cjsatuforc/Mendel-90/Build Manual (DRAFT - NOT COMPLETE OR VERIFIED)/link to extruder assembly instructions.txt

http://reprap.org/wiki/Prusa_i3_Rework_Extruder_assembly
