cjsatuforc/Mendel-90/Electronics/ATX PSU.step

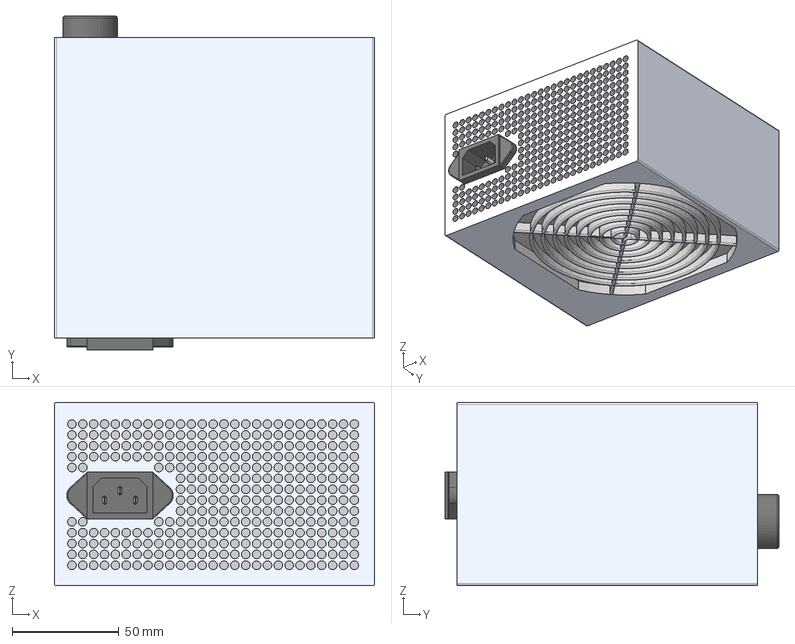
[picture p1: CAD file, 2018-10-25]
Electronics/ATX PSU.step
149.9 x 156.2 x 85.7 mm
