cjsatuforc/Mendel-90/Hardware/8mm Smooth Rod 481mm.step

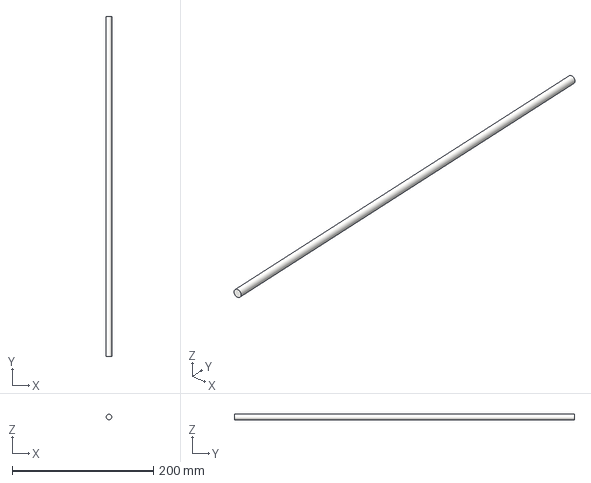
[picture p2: CAD file, 2018-10-25]
Hardware/8mm Smooth Rod 481mm.step
7.99 x 481.0 x 8.00 mm
