cjsatuforc/Mendel-90/Printed Parts/Enclosure/Hinge 1.step

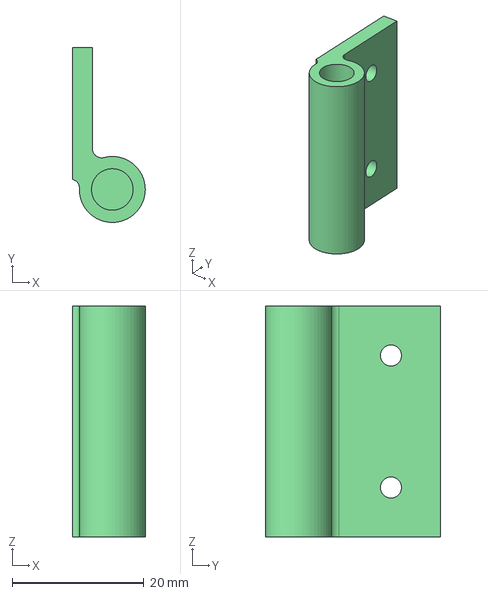
[picture p3: CAD file, 2018-10-25]
Printed Parts/Enclosure/Hinge 1.step
11.0 x 26.5 x 35.0 mm
