cjsatuforc/Mendel-90/Printed Parts/fan guard.step

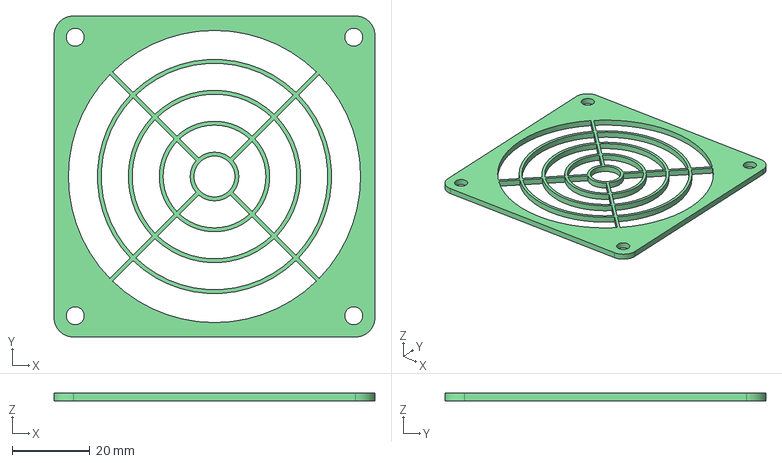
[picture p4: CAD file, 2018-10-25]
Printed Parts/fan guard.step
82.4 x 82.4 x 2.00 mm
