cjsatuforc/Mendel-90/Sheets/Base.step

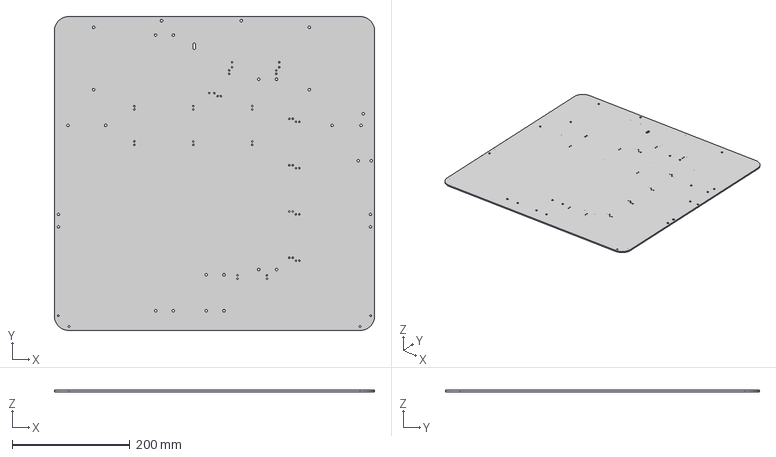
[picture p5: CAD file, 2018-10-25]
Sheets/Base.step
544.0 x 533.0 x 3.00 mm
