cjsatuforc/Mendel-90/Sheets/Enclosure/Rear 2.step

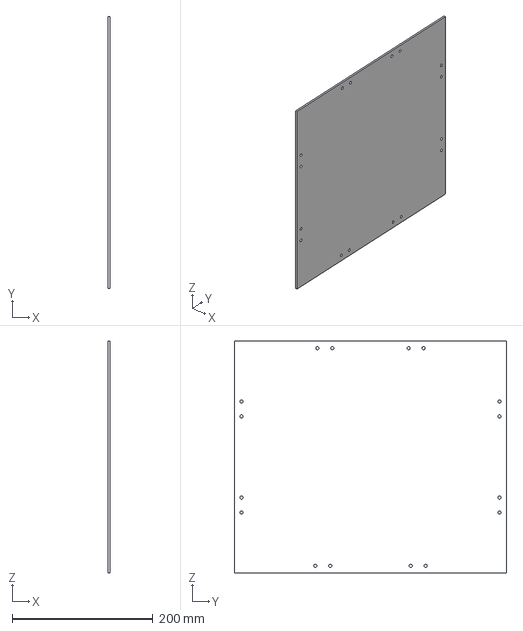
[picture p6: CAD file, 2018-10-25]
Sheets/Enclosure/Rear 2.step
3.00 x 386.7 x 329.4 mm
