cjsatuforc/Mendel-90/Printed Parts/Enclosure/Front Left.step

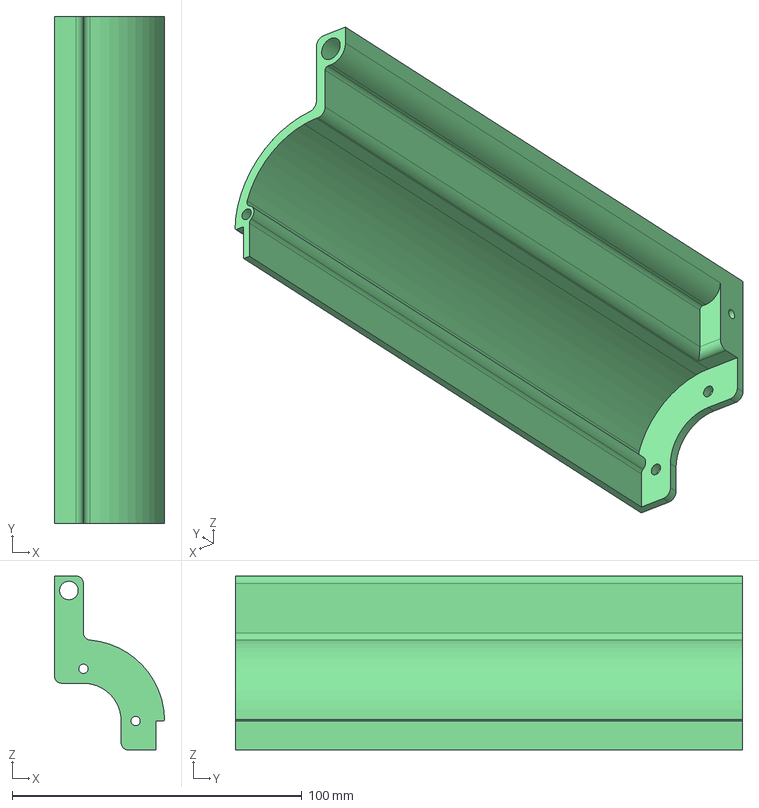
[picture p7: CAD file, 2018-10-25]
Printed Parts/Enclosure/Front Left.step
38.0 x 175.0 x 60.0 mm
