cjsatuforc/Mendel-90/Printed Parts/y motor bracket.step

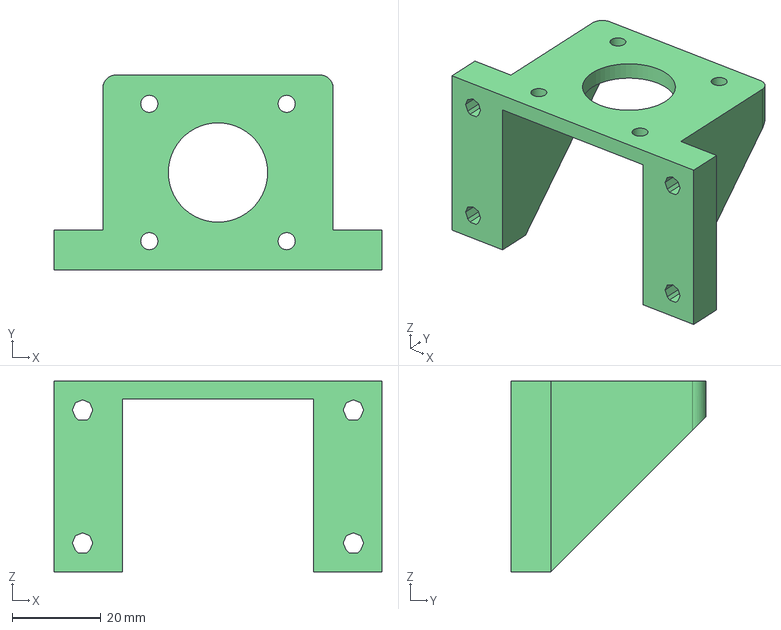
[picture p8: CAD file, 2018-10-25]
Printed Parts/y motor bracket.step
74.0 x 44.0 x 43.0 mm
