cjsatuforc/Mendel-90/Sheets/Enclosure/Back Window.step

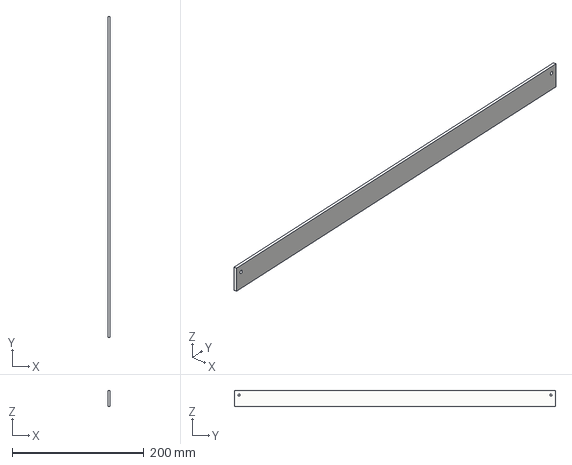
[picture p9: CAD file, 2018-10-25]
Sheets/Enclosure/Back Window.step
3.00 x 488.0 x 25.0 mm
