cjsatuforc/Mendel-90/Sheets/Gantry.step

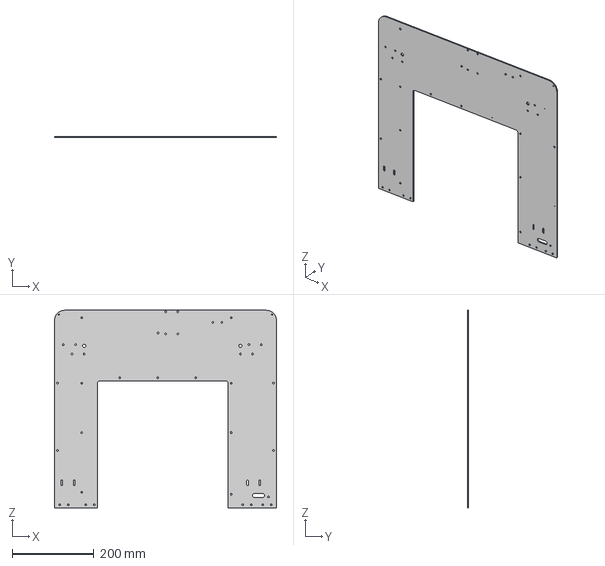
[picture p10: CAD file, 2018-10-25]
Sheets/Gantry.step
544.0 x 3.00 x 484.0 mm
