cjsatuforc/Mendel-90/Printed Parts/Enclosure/Front Left Bottom Bracket.step

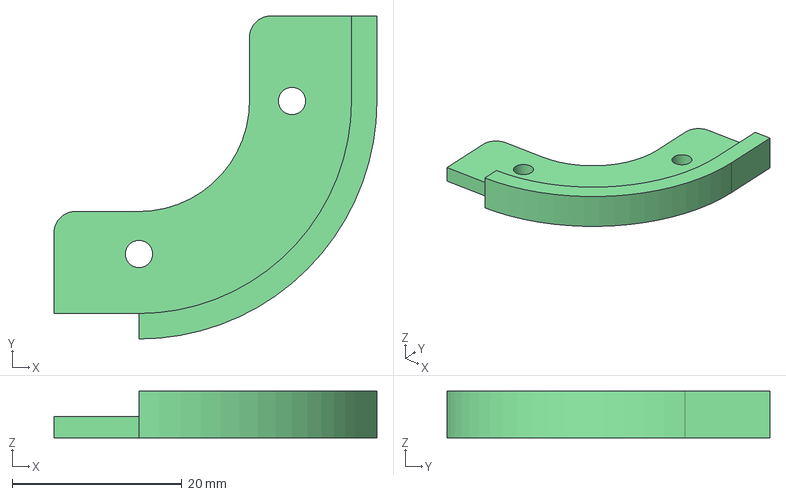
[picture p11: CAD file, 2018-10-25]
Printed Parts/Enclosure/Front Left Bottom Bracket.step
38.0 x 38.0 x 5.50 mm
