cjsatuforc/Mendel-90/Printed Parts/filament holder.step

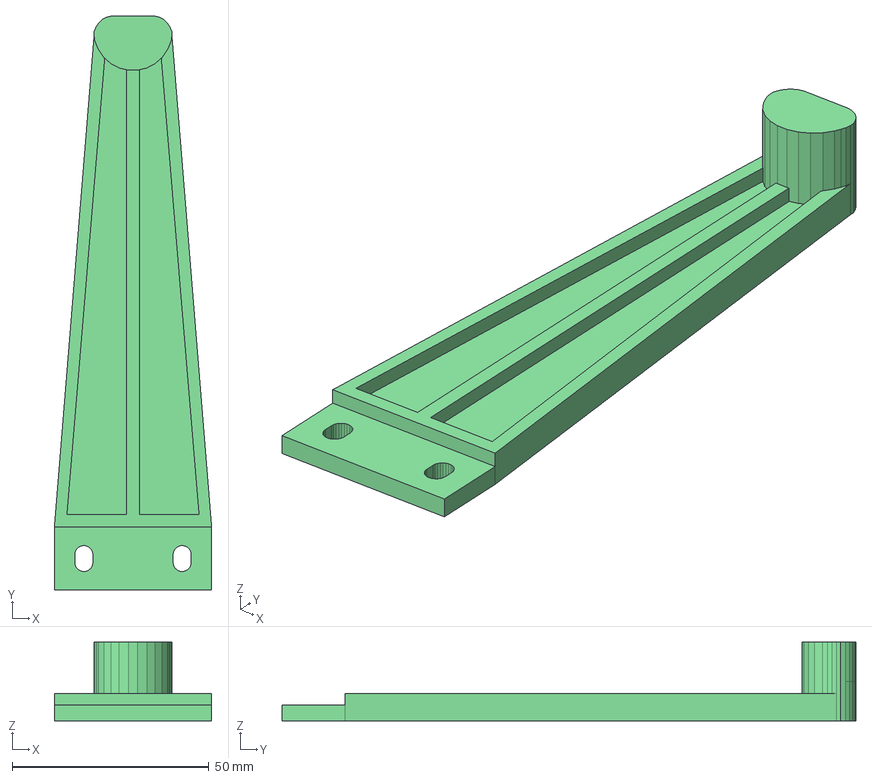
[picture p12: CAD file, 2018-10-25]
Printed Parts/filament holder.step
40.0 x 146.0 x 20.0 mm
