cjsatuforc/Mendel-90/Sheets/Enclosure/Door.step

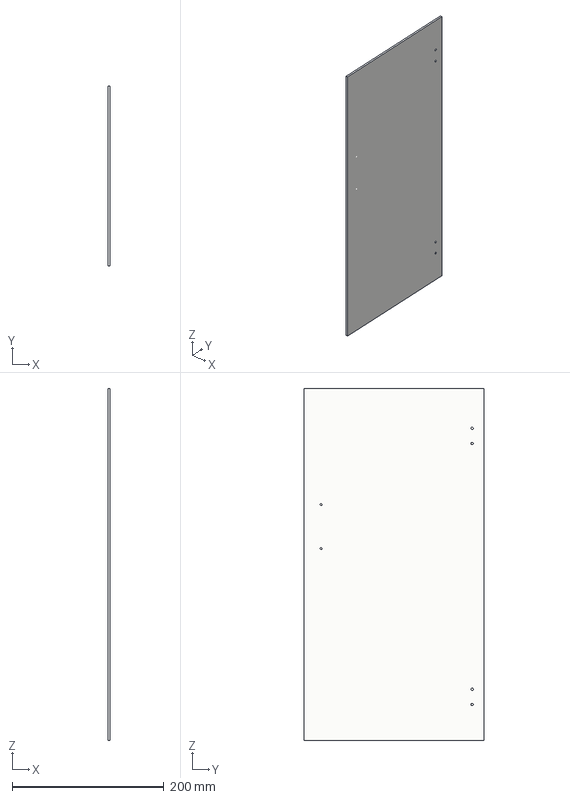
[picture p13: CAD file, 2018-10-25]
Sheets/Enclosure/Door.step
3.00 x 237.0 x 464.0 mm
