cjsatuforc/Mendel-90/Sheets/Y carriage.step

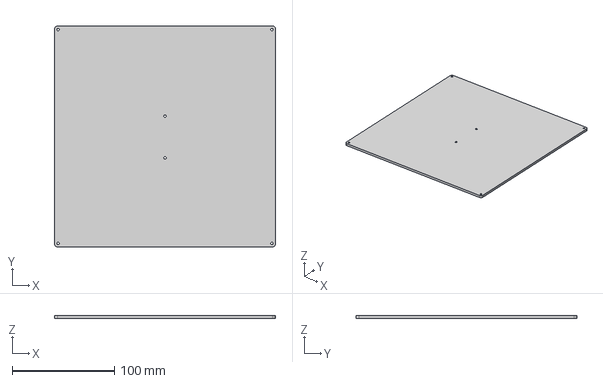
[picture p14: CAD file, 2018-10-25]
Sheets/Y carriage.step
216.0 x 216.0 x 3.00 mm
