cjsatuforc/Mendel-90/Hardware/8mm Smooth Rod 336mm.step

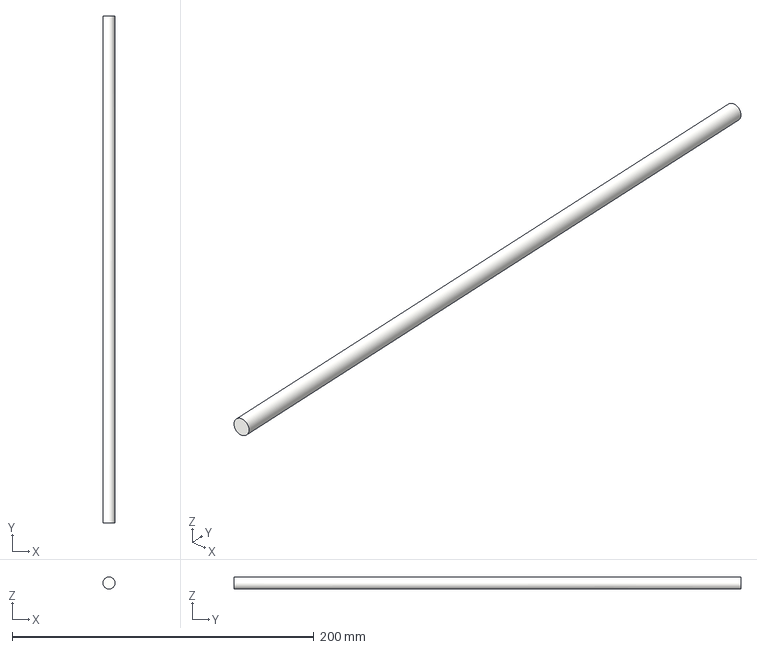
[picture p15: CAD file, 2018-10-25]
Hardware/8mm Smooth Rod 336mm.step
8.00 x 336.0 x 8.00 mm
