cjsatuforc/Mendel-90/Printed Parts/Enclosure/Top Right Guide 2.step

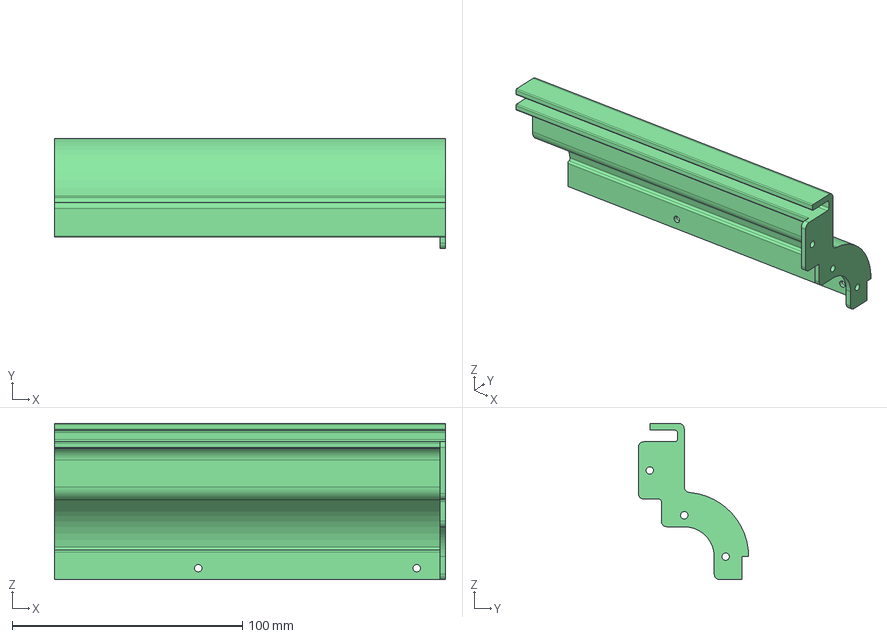
[picture p16: CAD file, 2018-10-25]
Printed Parts/Enclosure/Top Right Guide 2.step
170.0 x 48.0 x 68.0 mm
