cjsatuforc/Mendel-90/Printed Parts/Z bar clamp.step

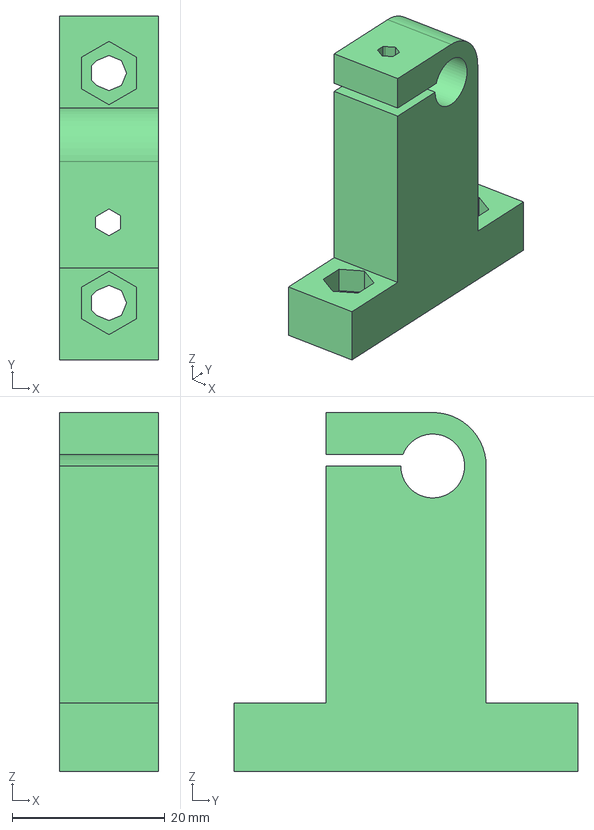
[picture p17: CAD file, 2018-10-25]
Printed Parts/Z bar clamp.step
13.0 x 45.0 x 47.0 mm
