cjsatuforc/Mendel-90/Sheets/Enclosure/Side Window.step

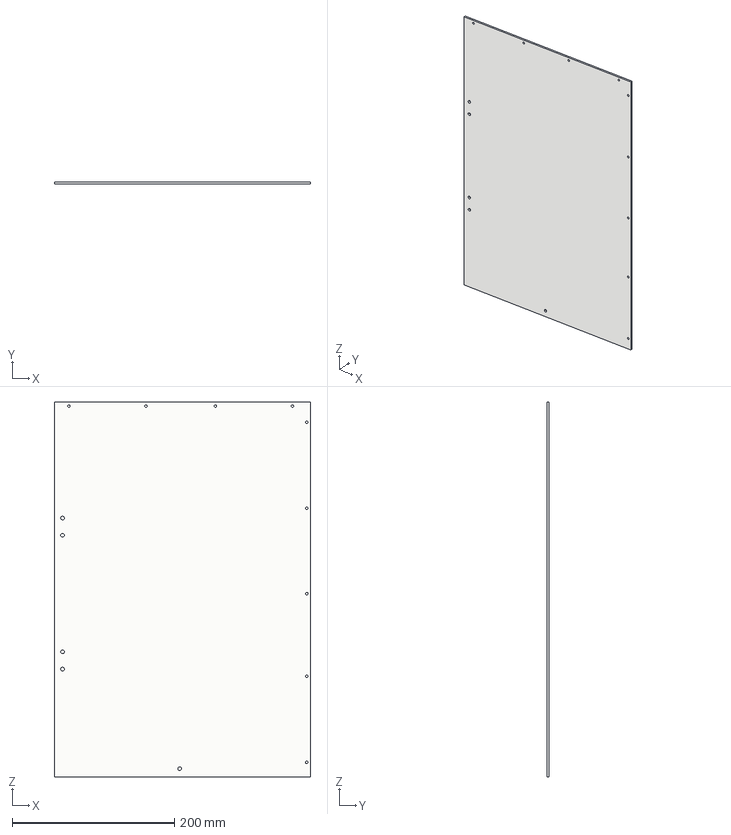
[picture p18: CAD file, 2018-10-25]
Sheets/Enclosure/Side Window.step
316.0 x 3.00 x 462.0 mm
