cjsatuforc/Mendel-90/Sheets/Left.step

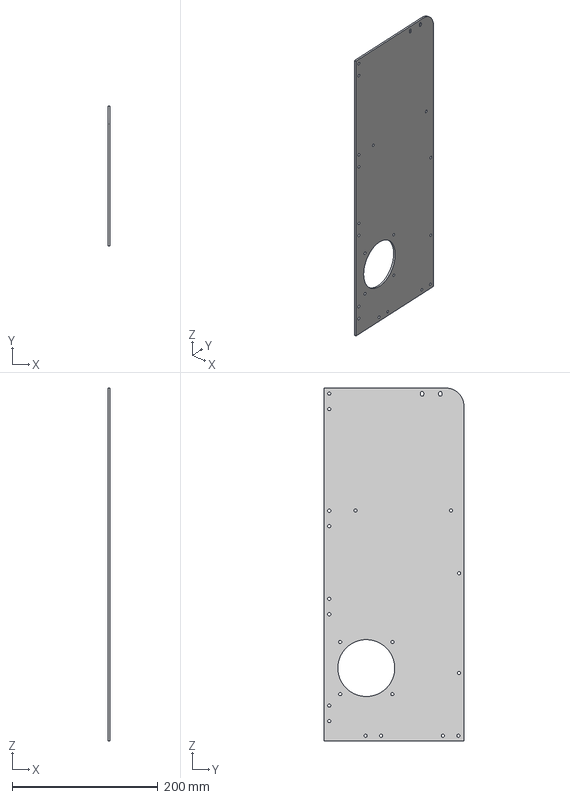
[picture p19: CAD file, 2018-10-25]
Sheets/Left.step
3.00 x 192.0 x 484.0 mm
