cjsatuforc/Mendel-90/Hardware/Flexible Coupling.step

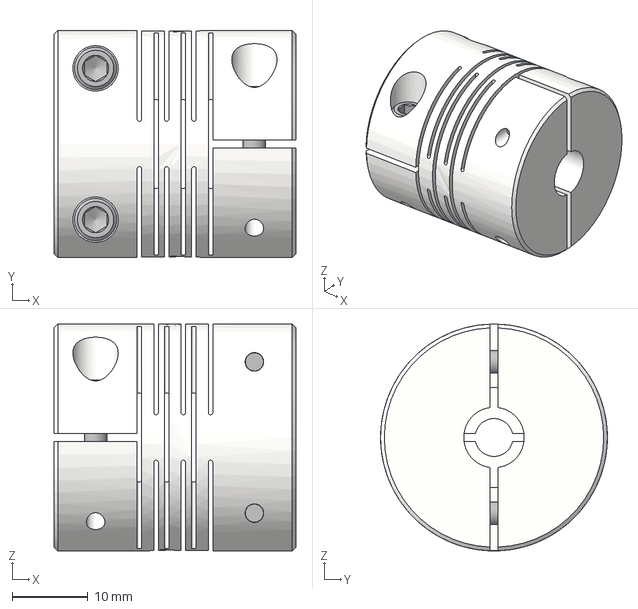
[picture p20: CAD file, 2018-10-25]
Hardware/Flexible Coupling.step
32.0 x 30.0 x 30.0 mm
_Type1-8.5x12
_Type11 x 4
