cjsatuforc/Mendel-90/Printed Parts/Enclosure/Top Left Guide 1.step

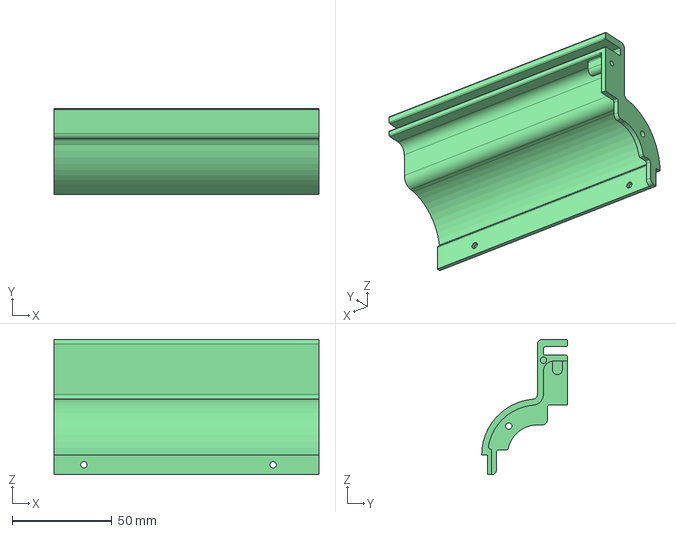
[picture p21: CAD file, 2018-10-25]
Printed Parts/Enclosure/Top Left Guide 1.step
133.0 x 43.0 x 68.0 mm
