cjsatuforc/Mendel-90/Printed Parts/Z Stepper Bracket RHS.step

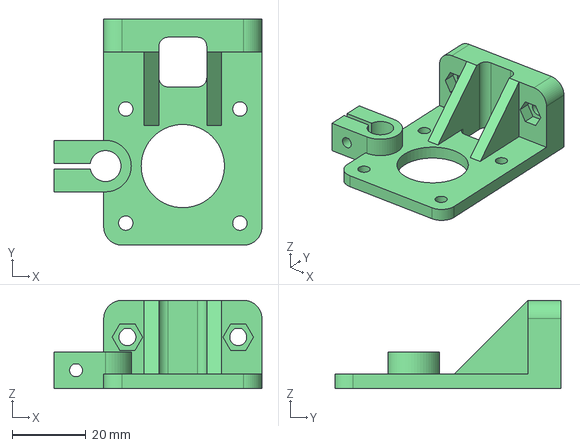
[picture p22: CAD file, 2018-10-25]
Printed Parts/Z Stepper Bracket RHS.step
56.5 x 61.5 x 24.0 mm
