cjsatuforc/Mendel-90/Sheets/Enclosure/Rear 1.step

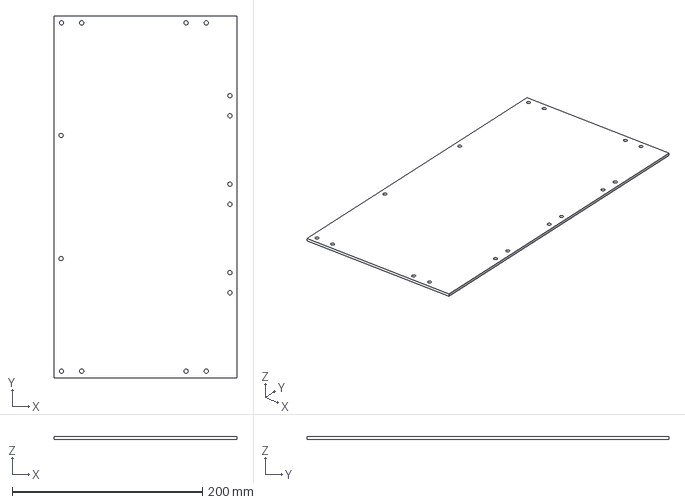
[picture p23: CAD file, 2018-10-25]
Sheets/Enclosure/Rear 1.step
192.0 x 380.8 x 3.00 mm
