cjsatuforc/Mendel-90/Sheets/Right.step

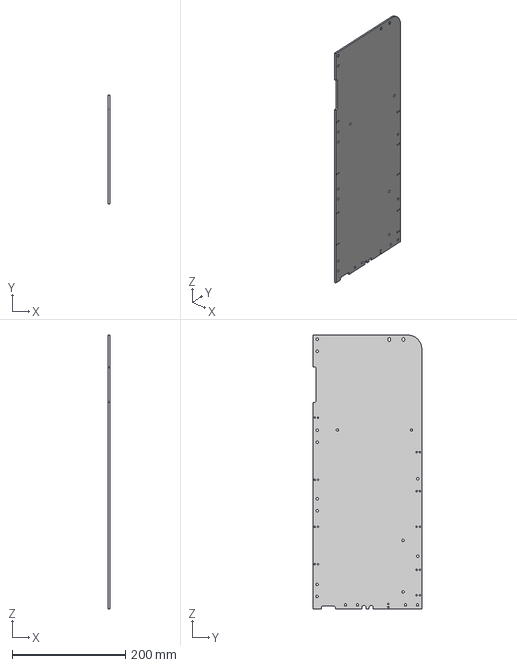
[picture p24: CAD file, 2018-10-25]
Sheets/Right.step
3.00 x 192.0 x 484.0 mm
