cjsatuforc/Mendel-90/Printed Parts/Enclosure/6mm pin.step

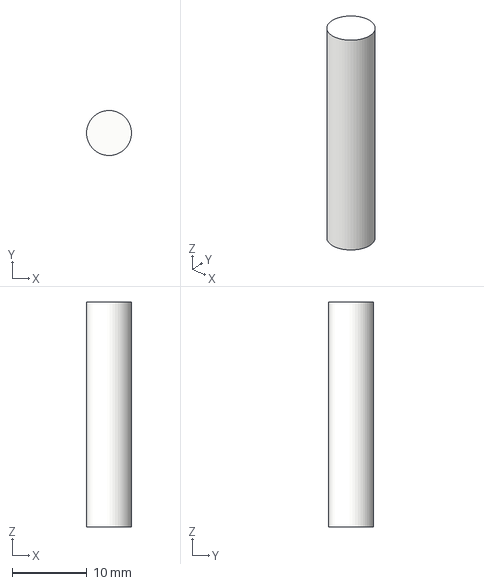
[picture p25: CAD file, 2018-10-25]
Printed Parts/Enclosure/6mm pin.step
5.99 x 6.00 x 30.0 mm
