cjsatuforc/Mendel-90/Hardware/8mm Smooth Rod 472,8 mm.step

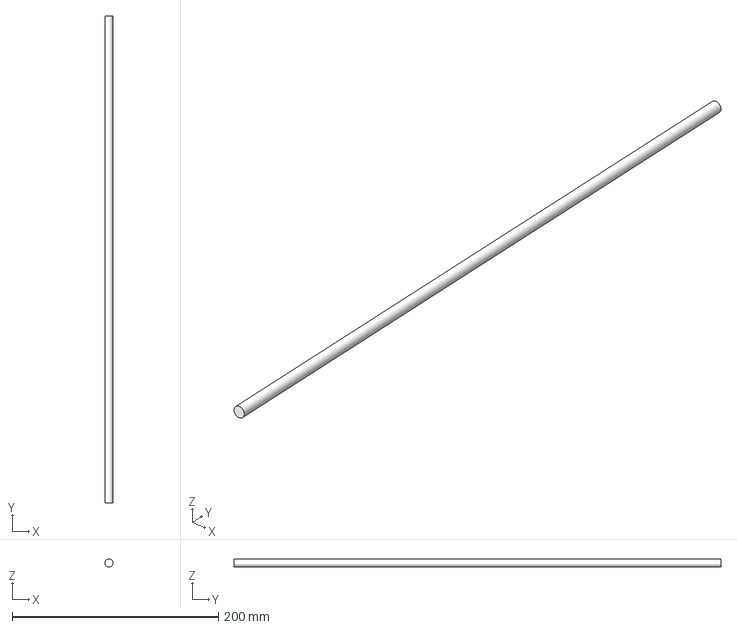
[picture p26: CAD file, 2018-10-25]
Hardware/8mm Smooth Rod 472,8 mm.step
7.99 x 472.8 x 8.00 mm
