cjsatuforc/Mendel-90/Printed Parts/spoolholder.step

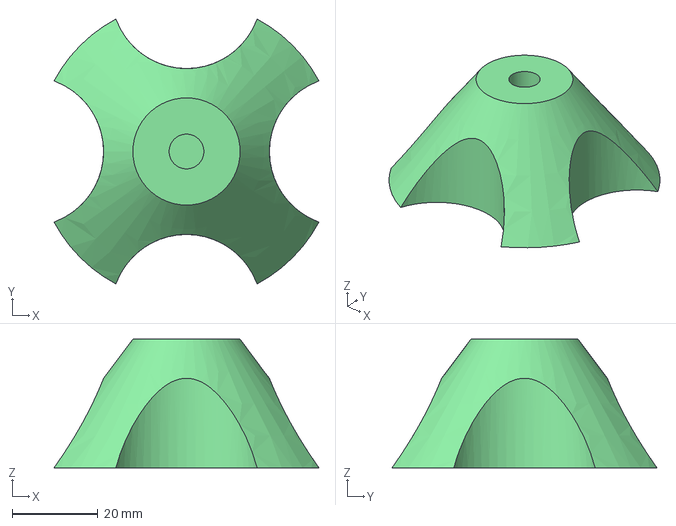
[picture p27: CAD file, 2018-10-25]
Printed Parts/spoolholder.step
61.8 x 61.8 x 30.0 mm
