cjsatuforc/Mendel-90/Printed Parts/Fixing Block.step

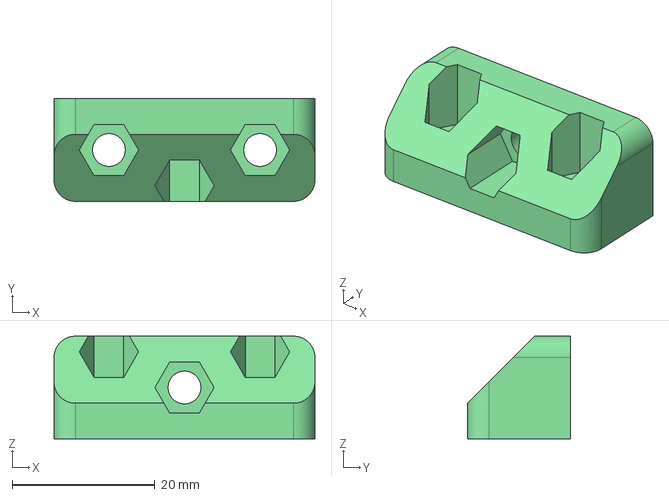
[picture p28: CAD file, 2018-10-25]
Printed Parts/Fixing Block.step
36.6 x 14.4 x 14.4 mm
