cjsatuforc/Mendel-90/Printed Parts/Enclosure/Front Stand Extension.step

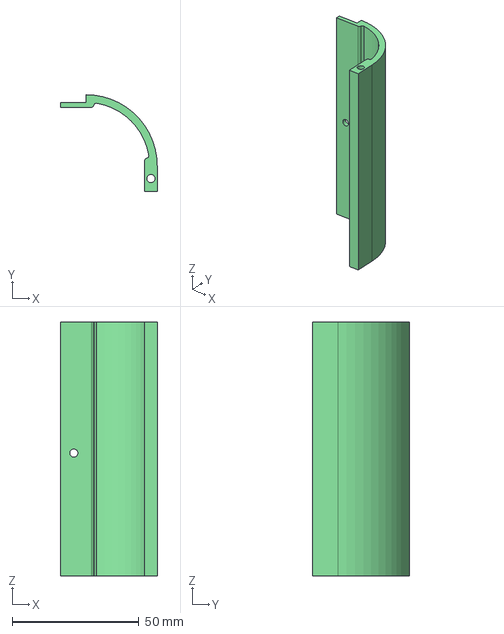
[picture p29: CAD file, 2018-10-25]
Printed Parts/Enclosure/Front Stand Extension.step
38.0 x 38.0 x 100.0 mm
