cjsatuforc/Mendel-90/Printed Parts/X endstop.step

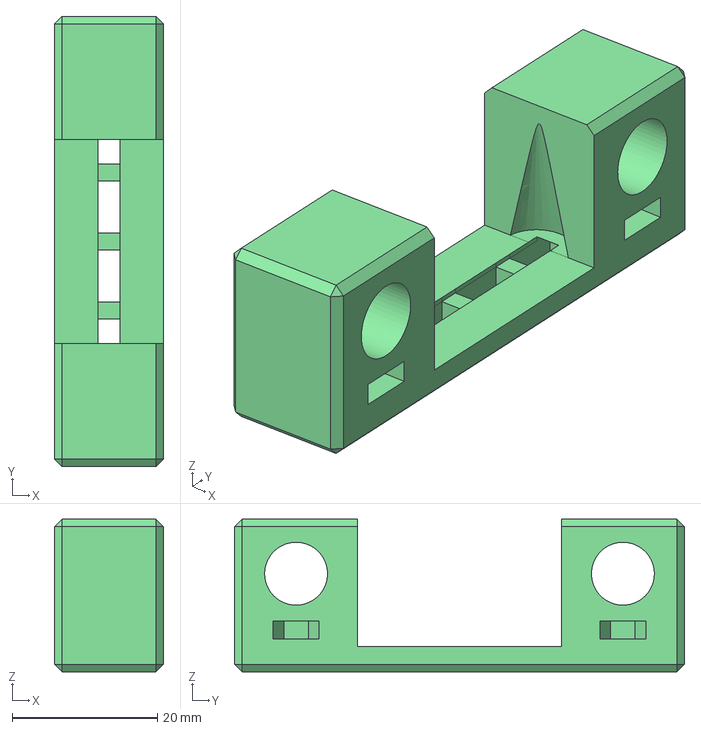
[picture p30: CAD file, 2018-10-25]
Printed Parts/X endstop.step
15.0 x 62.0 x 21.0 mm
