cjsatuforc/Mendel-90/Printed Parts/Enclosure/Front Stand 2.step

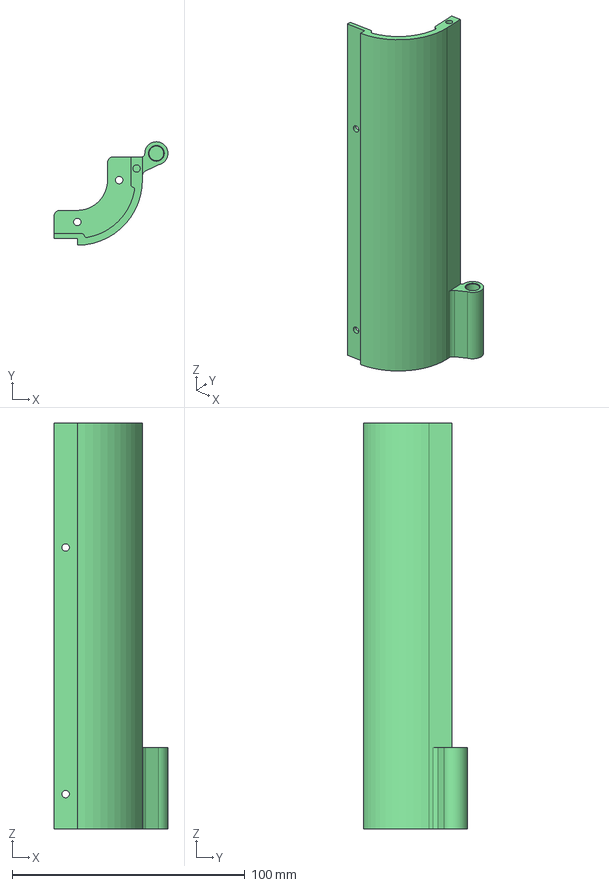
[picture p31: CAD file, 2018-10-25]
Printed Parts/Enclosure/Front Stand 2.step
49.0 x 44.5 x 174.5 mm
