cjsatuforc/Mendel-90/Printed Parts/X End Idler.step

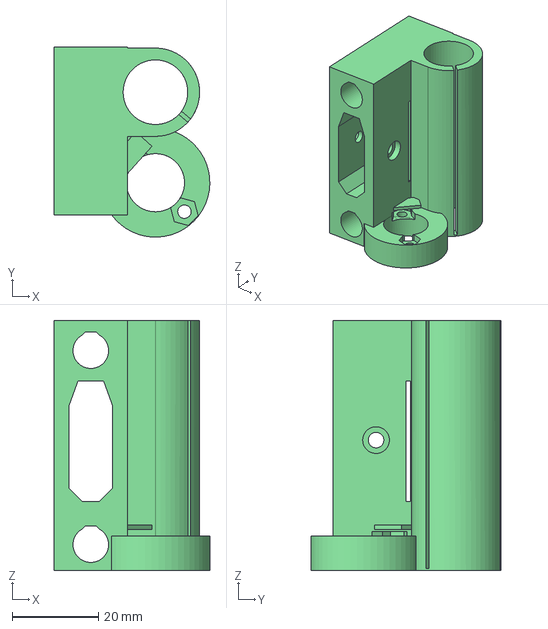
[picture p32: CAD file, 2018-10-25]
Printed Parts/X End Idler.step
36.1 x 44.1 x 58.0 mm
