cjsatuforc/Mendel-90/Printed Parts/Enclosure/Latch.step

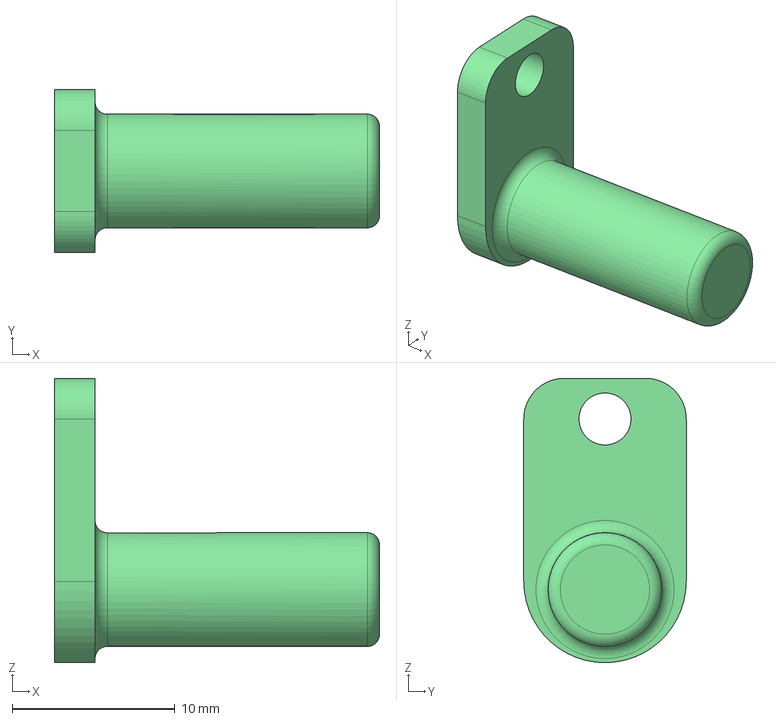
[picture p33: CAD file, 2018-10-25]
Printed Parts/Enclosure/Latch.step
20.0 x 10.0 x 17.5 mm
