cjsatuforc/Mendel-90/Printed Parts/X Carriage.step

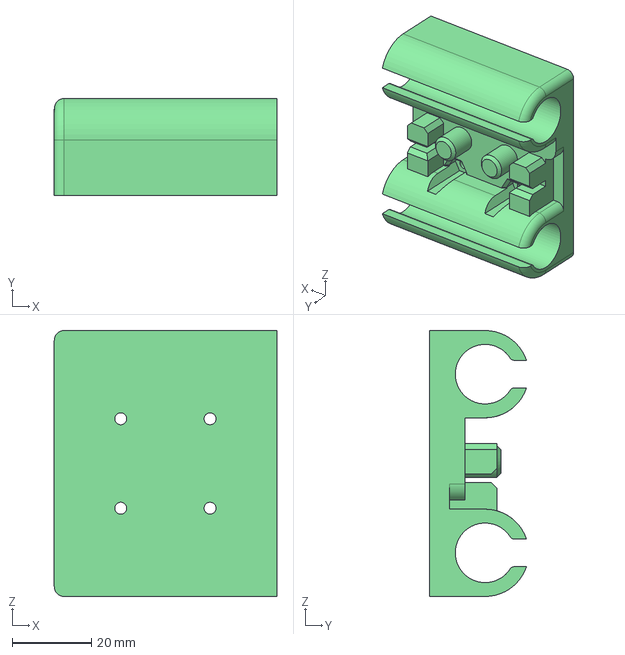
[picture p34: CAD file, 2018-10-25]
Printed Parts/X Carriage.step
56.0 x 24.4 x 67.0 mm
