cjsatuforc/Mendel-90/Hardware/NEMA 17 Stepper Motor.step

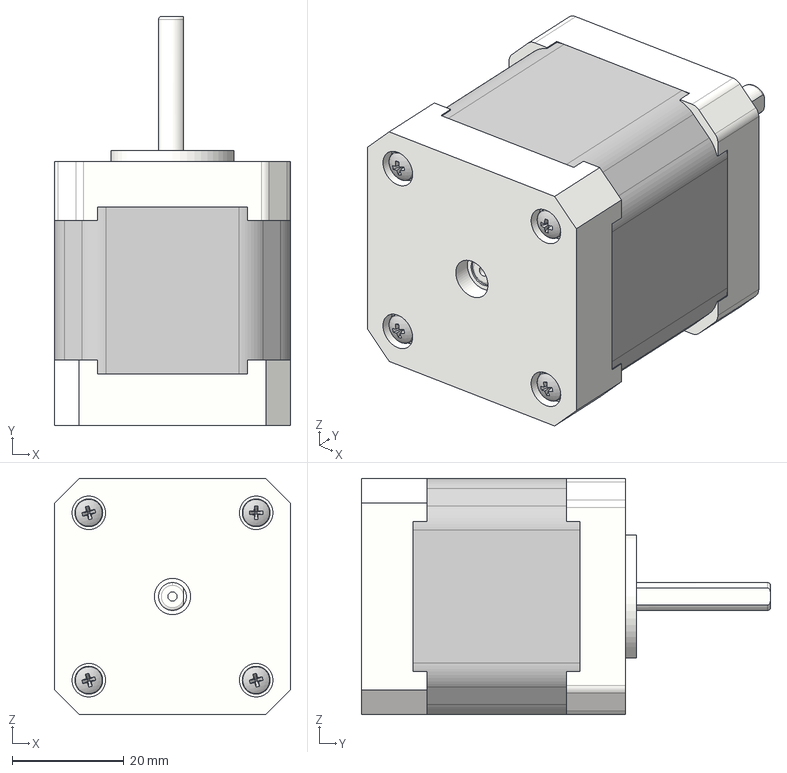
[picture p35: CAD file, 2018-10-25]
Hardware/NEMA 17 Stepper Motor.step
42.3 x 73.3 x 42.3 mm
NEMA 17 Stepper Motor Middle
NEMA 17 Stepper Motor Top
NEMA 17 Stepper Motor Bottom
NEMA 17 Stepper Motor Shaft
pan cross head_am_B18.6.7M - M2.5 x 0 x 4
