cjsatuforc/Mendel-90/Printed Parts/Enclosure/Sphere Left.step

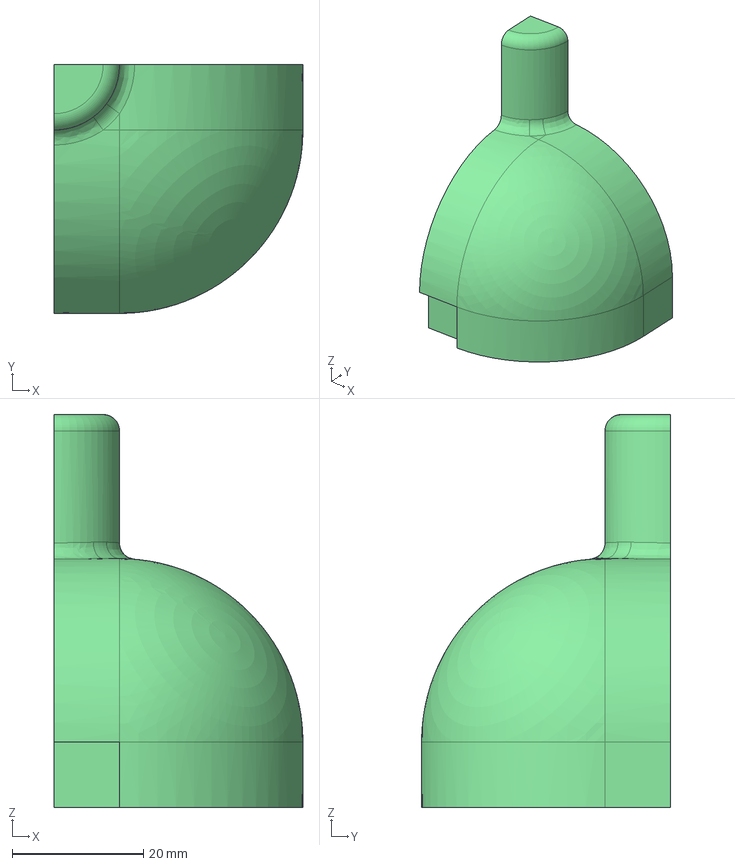
[picture p36: CAD file, 2018-10-25]
Printed Parts/Enclosure/Sphere Left.step
38.0 x 38.0 x 60.0 mm
