cjsatuforc/Mendel-90/Printed Parts/Z Isolator.step

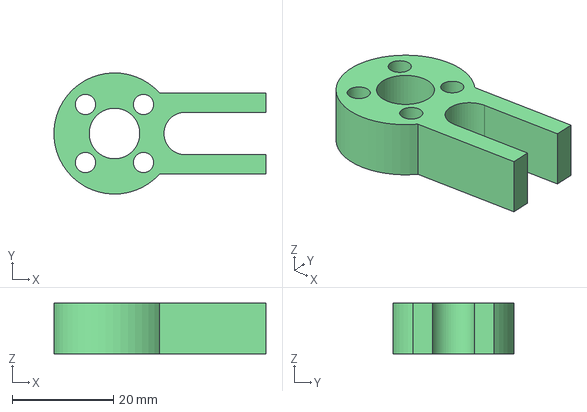
[picture p37: CAD file, 2018-10-25]
Printed Parts/Z Isolator.step
42.0 x 24.0 x 10.0 mm
