cjsatuforc/Mendel-90/Printed Parts/Enclosure/Top Left Bracket.step

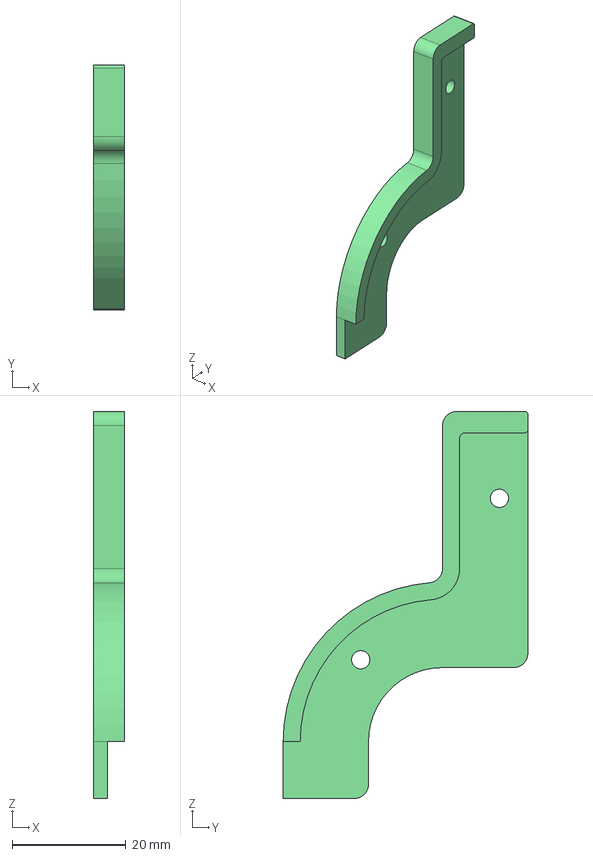
[picture p38: CAD file, 2018-10-25]
Printed Parts/Enclosure/Top Left Bracket.step
5.50 x 43.0 x 68.0 mm
