cjsatuforc/Mendel-90/Printed Parts/Linear Bearing Block.step

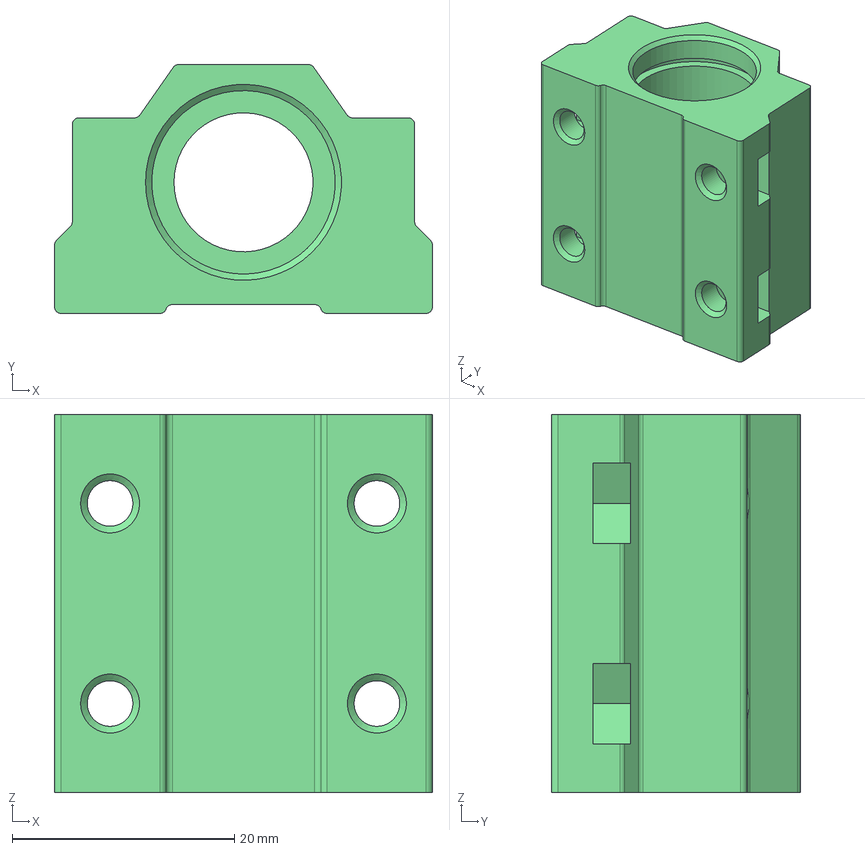
[picture p39: CAD file, 2018-10-25]
Printed Parts/Linear Bearing Block.step
34.0 x 22.4 x 34.0 mm
