cjsatuforc/Mendel-90/Printed Parts/X End Motor.step

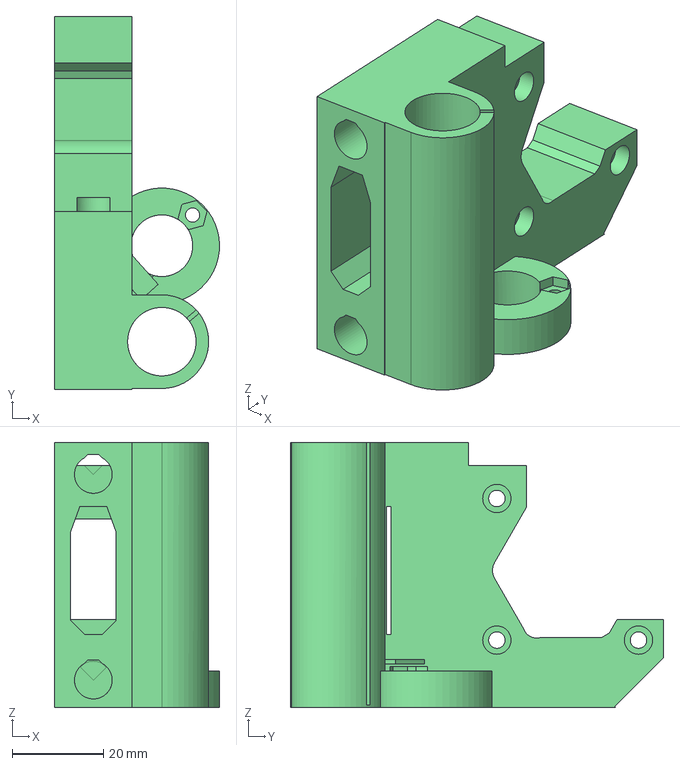
[picture p40: CAD file, 2018-10-25]
Printed Parts/X End Motor.step
36.1 x 81.7 x 58.0 mm
