cjsatuforc/Mendel-90/Hardware/Microswitch Omron SS-5GL.step

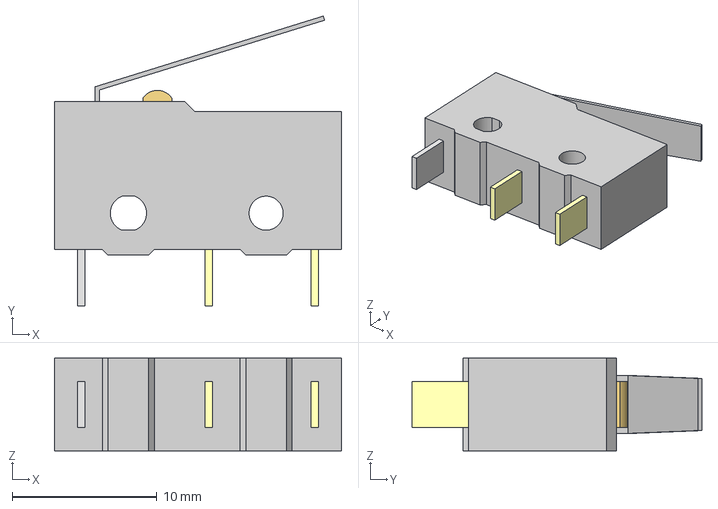
[picture p41: CAD file, 2018-10-25]
Hardware/Microswitch Omron SS-5GL.step
19.8 x 20.0 x 6.40 mm
SS_01GL_E_BASE
SS_01GL_E_ACTUATOR
