cjsatuforc/Mendel-90/Printed Parts/atx long.step

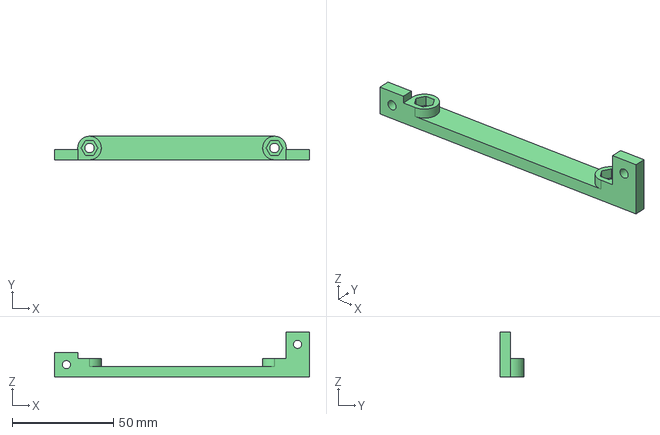
[picture p42: CAD file, 2018-10-25]
Printed Parts/atx long.step
125.8 x 11.7 x 22.0 mm
