cjsatuforc/Mendel-90/Printed Parts/Enclosure/Handle.step

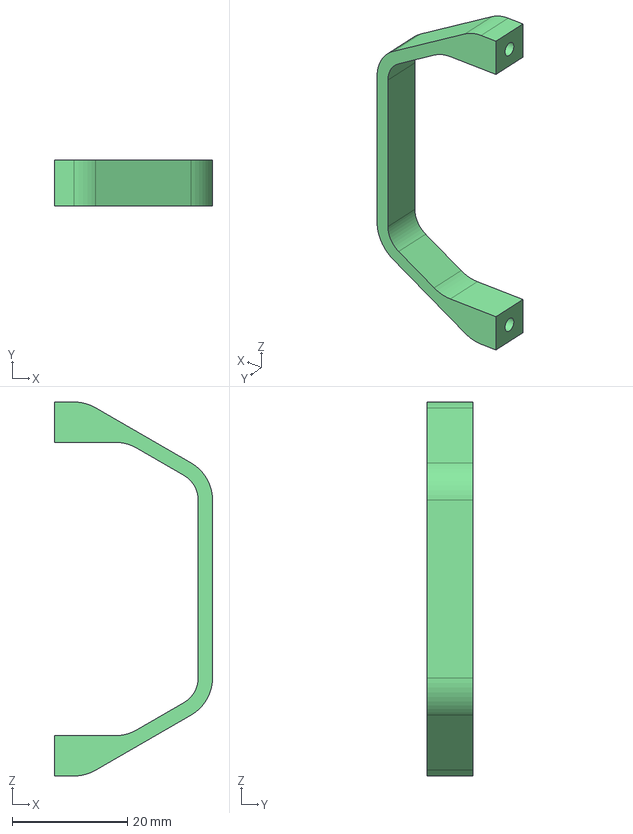
[picture p43: CAD file, 2018-10-25]
Printed Parts/Enclosure/Handle.step
27.5 x 8.00 x 65.0 mm
