cjsatuforc/Mendel-90/Hardware/GT2 Pulley 20 Tooth.step

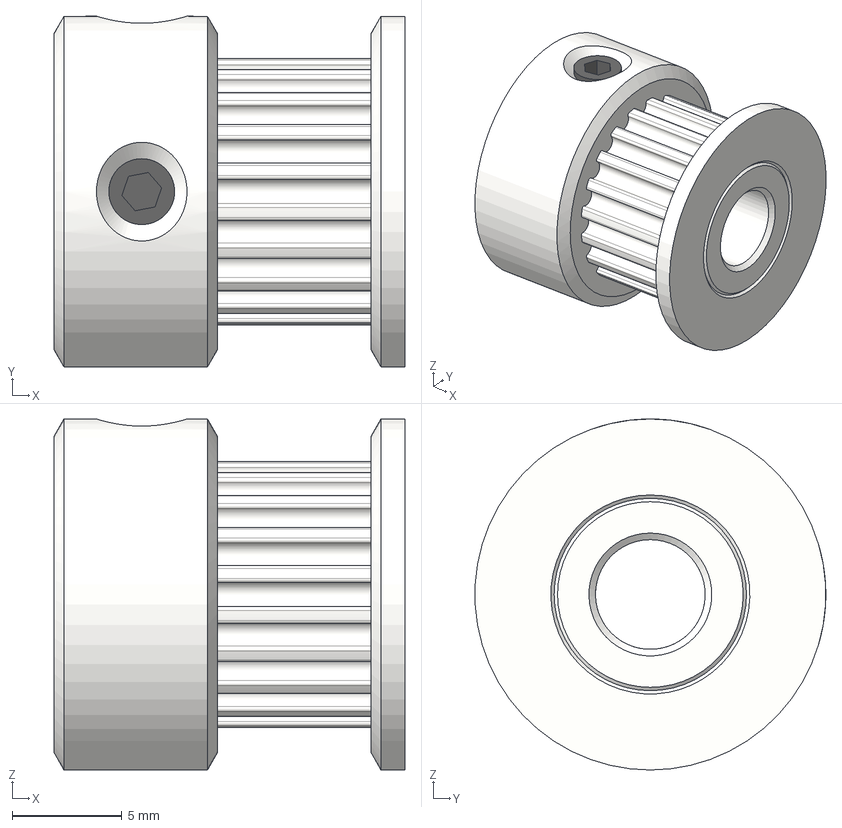
[picture p44: CAD file, 2018-10-25]
Hardware/GT2 Pulley 20 Tooth.step
16.0 x 16.0 x 16.0 mm
