cjsatuforc/Mendel-90/Printed Parts/y belt holder.step

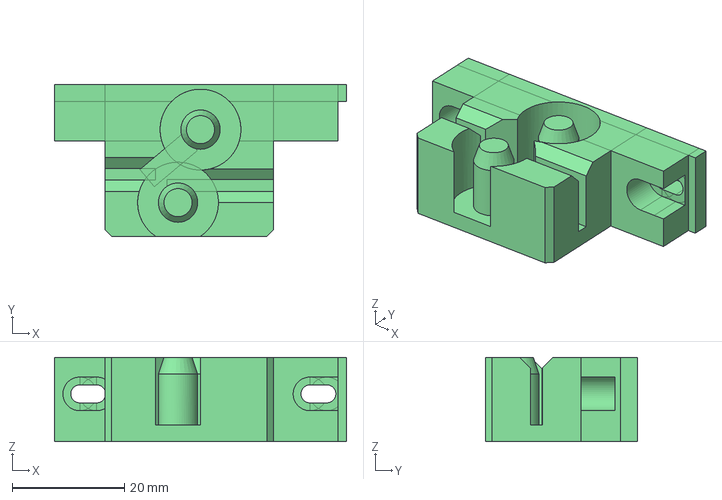
[picture p45: CAD file, 2018-10-25]
Printed Parts/y belt holder.step
52.0 x 27.0 x 15.0 mm
