cjsatuforc/Mendel-90/Printed Parts/bed fan duct.step

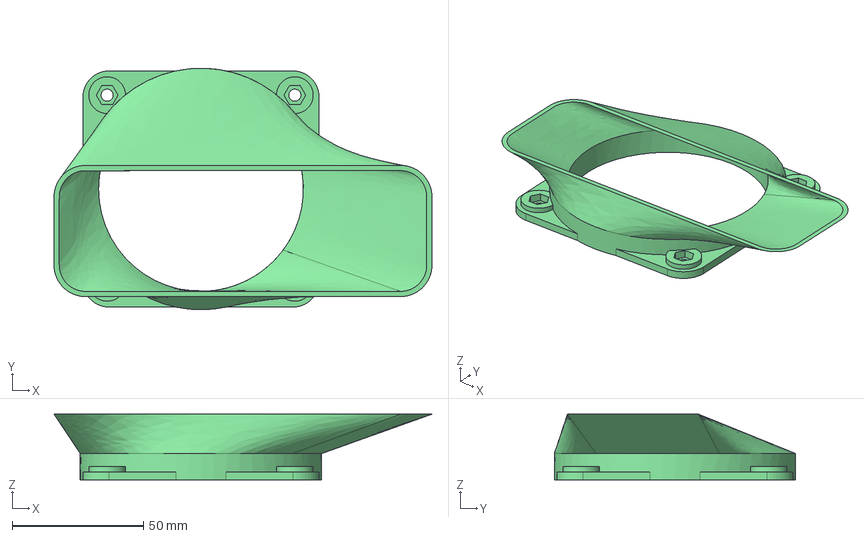
[picture p46: CAD file, 2018-10-25]
Printed Parts/bed fan duct.step
144.0 x 92.0 x 25.0 mm
