cjsatuforc/Mendel-90/Printed Parts/y idler bracket.step

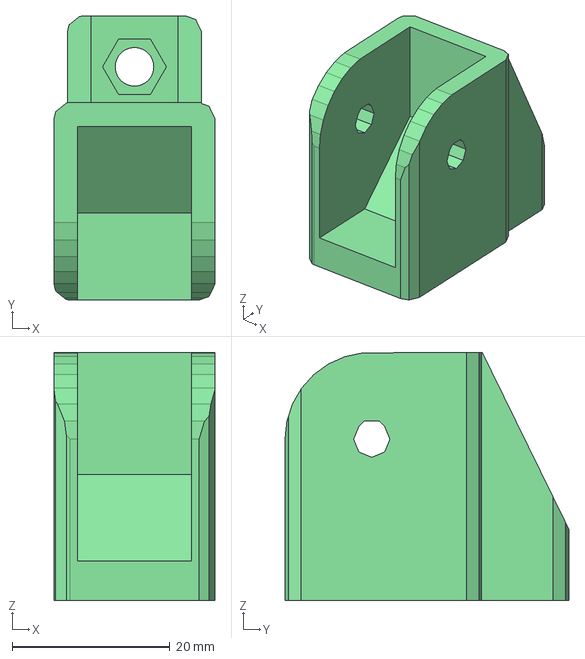
[picture p47: CAD file, 2018-10-25]
Printed Parts/y idler bracket.step
20.4 x 36.0 x 31.5 mm
