cjsatuforc/Mendel-90/Printed Parts/atx short.step

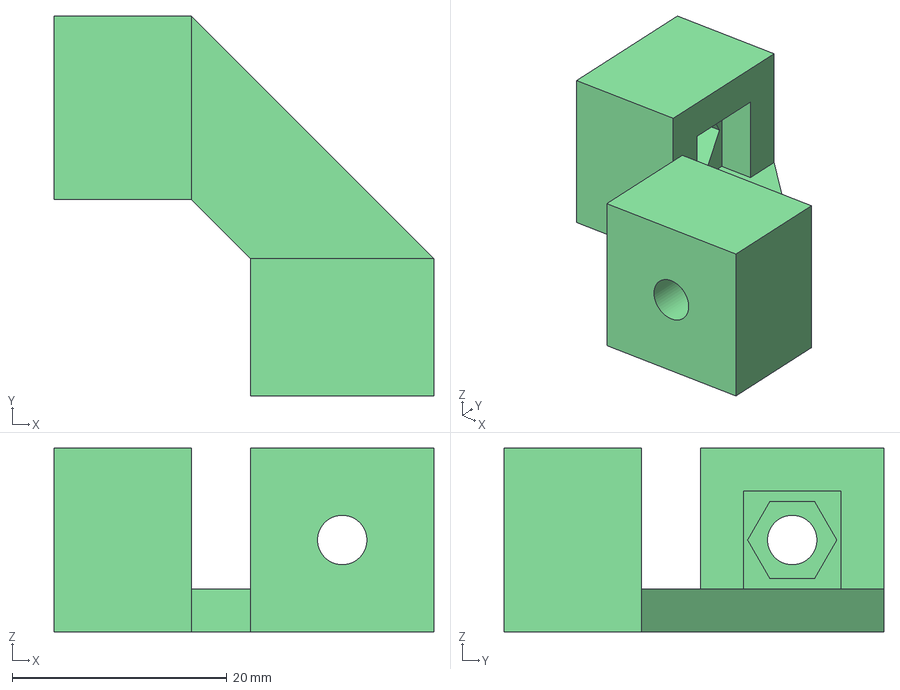
[picture p48: CAD file, 2018-10-25]
Printed Parts/atx short.step
35.4 x 35.4 x 17.1 mm
