cjsatuforc/Mendel-90/Printed Parts/y bar clamp switch.step

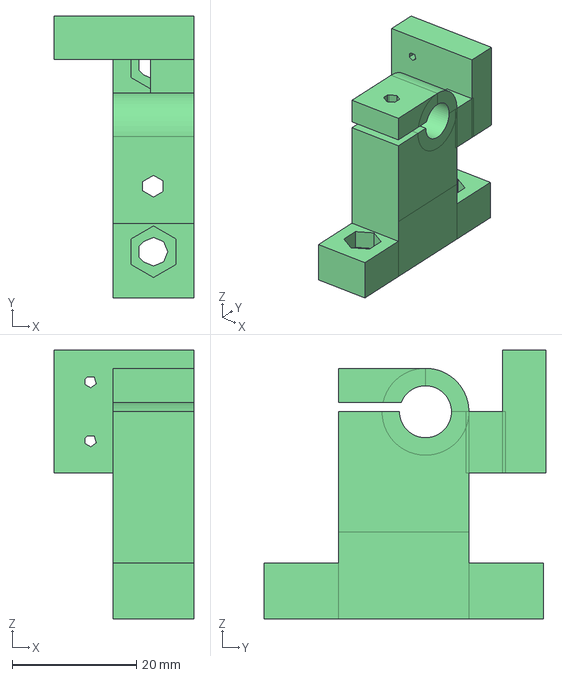
[picture p49: CAD file, 2018-10-25]
Printed Parts/y bar clamp switch.step
22.5 x 45.4 x 43.2 mm
