cjsatuforc/Mendel-90/Hardware/80mm fan.step

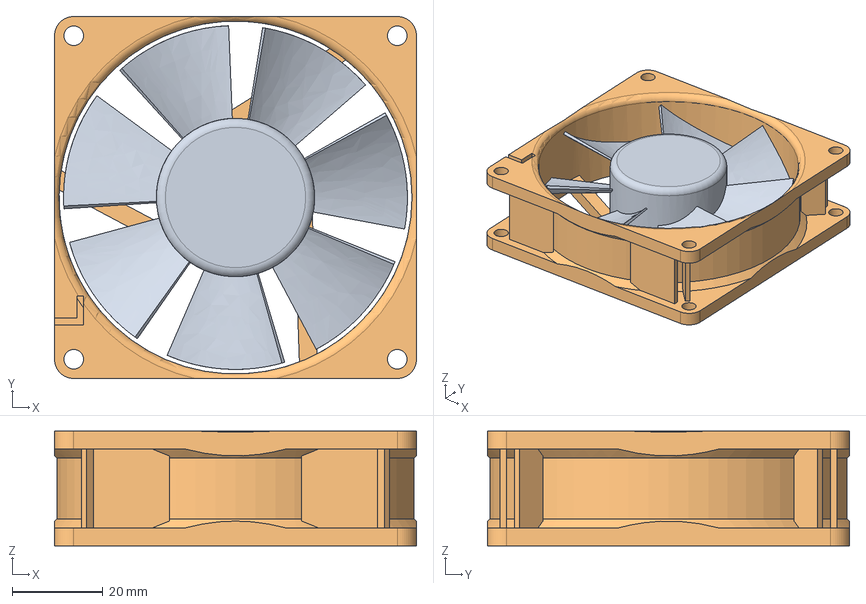
[picture p50: CAD file, 2018-10-25]
Hardware/80mm fan.step
80.0 x 80.0 x 25.4 mm
