cjsatuforc/Mendel-90/Printed Parts/Enclosure/Front Middle.step

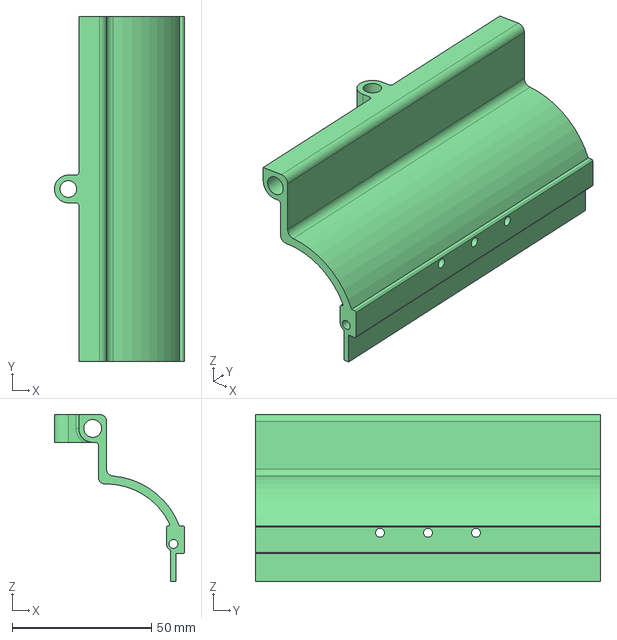
[picture p51: CAD file, 2018-10-25]
Printed Parts/Enclosure/Front Middle.step
46.8 x 124.0 x 60.0 mm
