cjsatuforc/Mendel-90/Printed Parts/y bar clamp.step

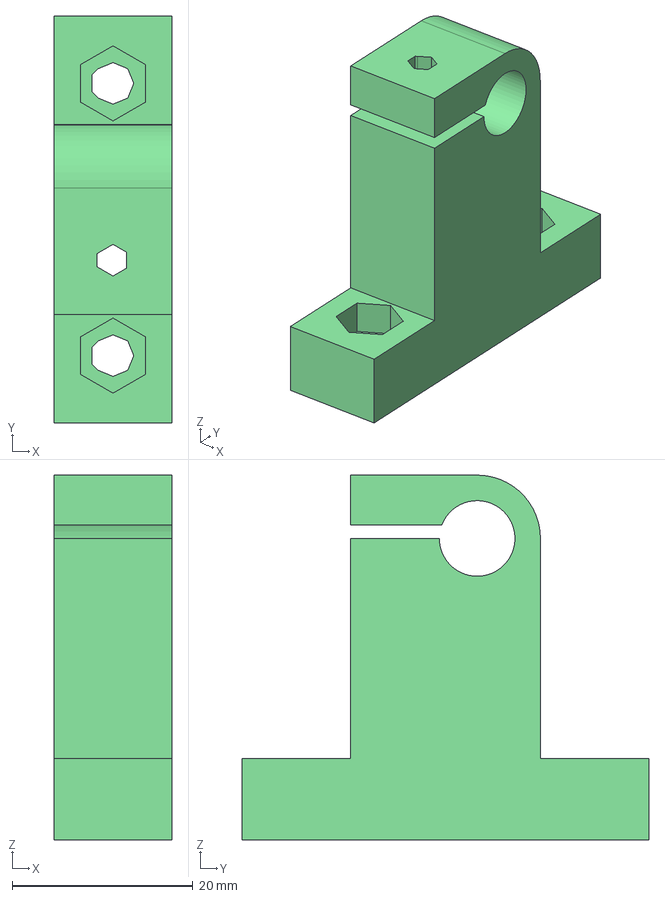
[picture p52: CAD file, 2018-10-25]
Printed Parts/y bar clamp.step
13.0 x 45.0 x 40.3 mm
