cjsatuforc/Mendel-90/Hardware/LM8UU.step

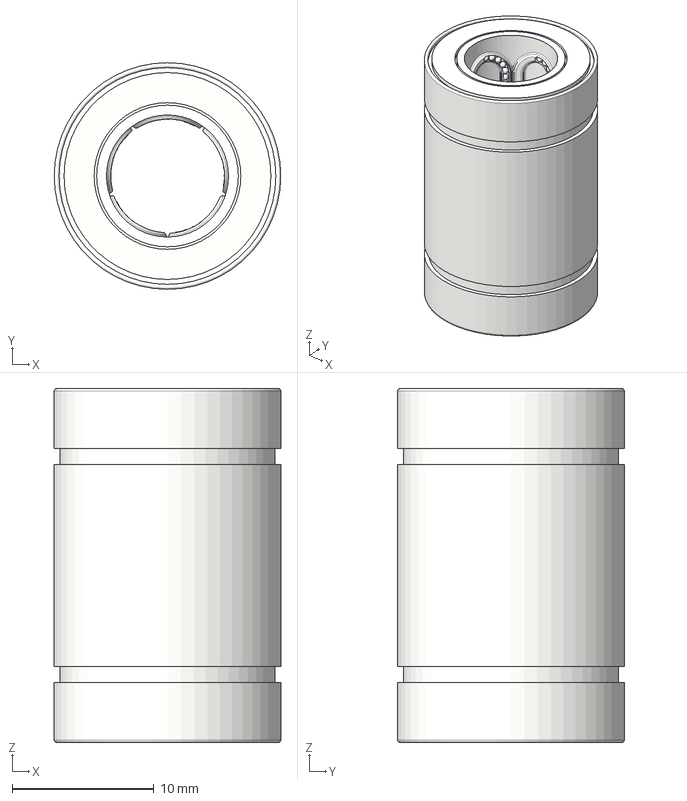
[picture p53: CAD file, 2018-10-25]
Hardware/LM8UU.step
16.0 x 16.0 x 25.0 mm
