cjsatuforc/Mendel-90/Printed Parts/Enclosure/3mm pin.step

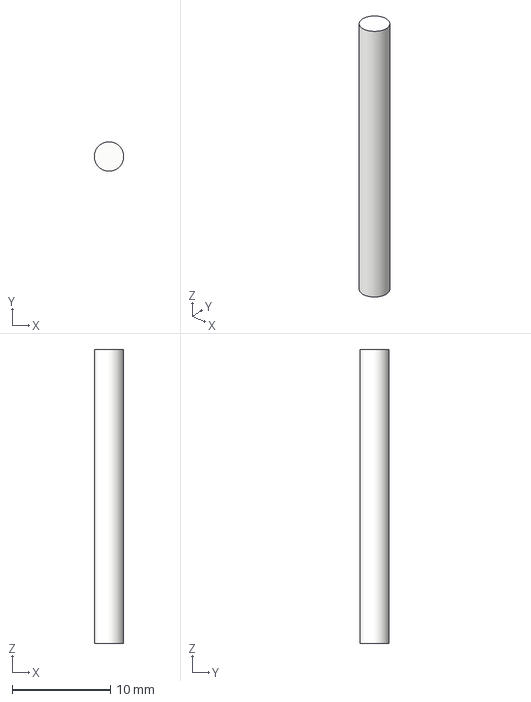
[picture p54: CAD file, 2018-10-25]
Printed Parts/Enclosure/3mm pin.step
3.00 x 3.00 x 30.0 mm
