cjsatuforc/Mendel-90/Hardware/Ball Bearing 608.step

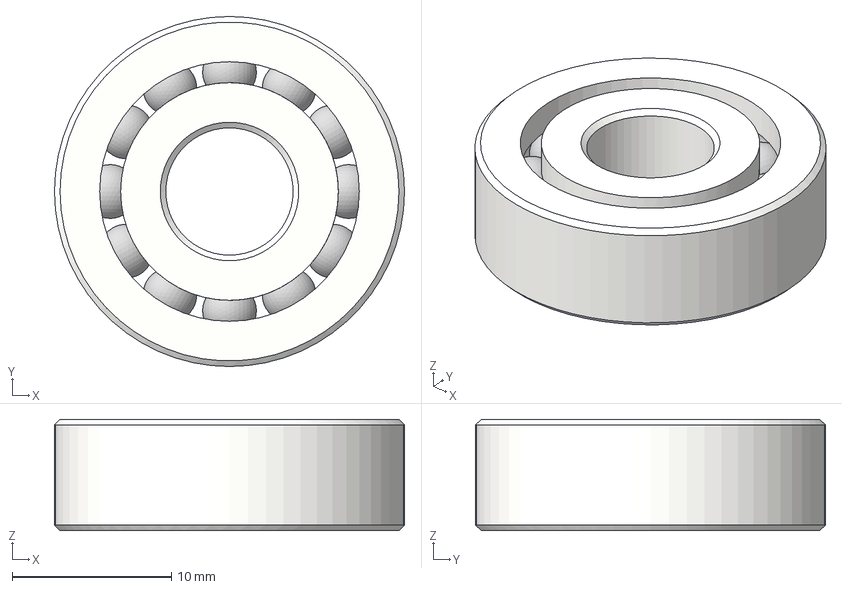
[picture p55: CAD file, 2018-10-25]
Hardware/Ball Bearing 608.step
22.0 x 22.0 x 7.00 mm
