cjsatuforc/Mendel-90/Printed Parts/Enclosure/Lock Pin.step

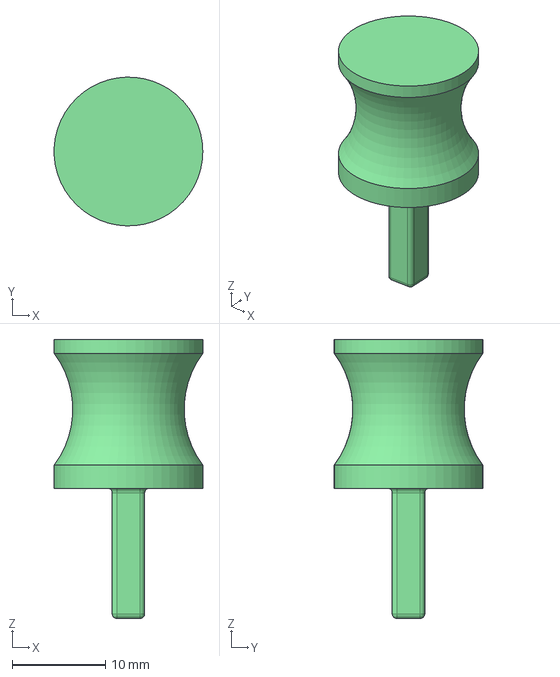
[picture p56: CAD file, 2018-10-25]
Printed Parts/Enclosure/Lock Pin.step
16.0 x 16.0 x 30.0 mm
