cjsatuforc/Mendel-90/Hardware/GT2 Pulley.step

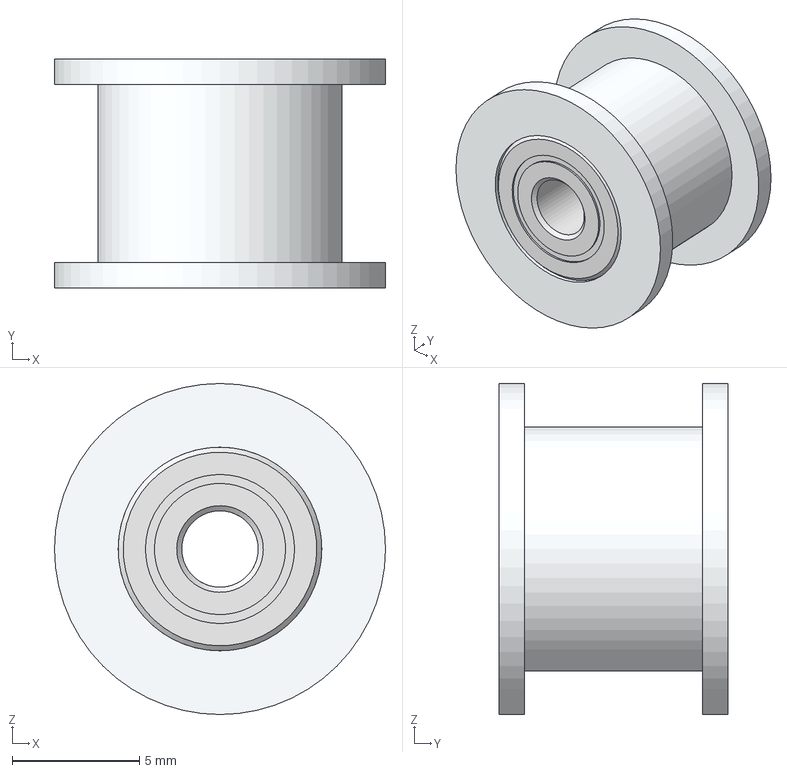
[picture p57: CAD file, 2018-10-25]
Hardware/GT2 Pulley.step
13.0 x 9.00 x 13.0 mm
1021795-IDLER PULLEY
1021795-693-2Z BEARING, 8 mm OD, 3 mm ID, 4 mm WIDTH_DEFAULT x 2
