cjsatuforc/Mendel-90/(list of files, cad)

Other CAD files:
Printed Parts/Z Stepper Bracket LHS.step
Printed Parts/Enclosure/Front Right Bottom Bracket.step
Printed Parts/Enclosure/Front Right.step
Printed Parts/Enclosure/Sphere Right.step
Printed Parts/Enclosure/Front Stand 1.step
Printed Parts/Enclosure/Top Right Bracket.step
Printed Parts/Enclosure/Top Left Guide 2.step
Printed Parts/Enclosure/Top Right Guide 1.step
Printed Parts/Enclosure/Hinge 2.step
Electronics/ATX PSU.f3d
Electronics/Heatbed MK42.f3d
Hardware/80mm fan.f3d
Hardware/8mm Smooth Rod 336mm.f3d
Hardware/8mm Smooth Rod 472,8 mm.f3d
Hardware/8mm Smooth Rod 481mm.f3d
Hardware/Ball Bearing 608.f3d
Hardware/Flexible Coupling.f3d
Hardware/GT2 Pulley 20 Tooth.f3d
Hardware/GT2 Pulley.f3d
Hardware/LM8UU.f3d
Hardware/M3 Lock Nut.f3d
Hardware/M3 Lock Nut.step
Hardware/M3 Nut.f3d
Hardware/M3 Nut.step
Hardware/M3 Star Washer.f3d
Hardware/M3 Star Washer.step
Hardware/M3 Washer.f3d
Hardware/M3 Washer.step
Hardware/M3x10.f3d
Hardware/M3x10.step
Hardware/M3x14.f3d
Hardware/M3x14.step
Hardware/M3x16.f3d
Hardware/M3x16.step
Hardware/M3x20 Standoff.f3d
Hardware/M3x20 Standoff.step
Hardware/M3x20.f3d
Hardware/M3x20.step
Hardware/M3x6mm.f3d
Hardware/M3x6mm.step
Hardware/M4 Lock Nut.f3d
Hardware/M4 Lock Nut.step
Hardware/M4 Washer.f3d
Hardware/M4 Washer.step
Hardware/M4x16.f3d
Hardware/M4x16.step
Hardware/M4x35(34).f3d
Hardware/M4x35(34).step
Hardware/Microswitch Omron SS-5GL.f3d
Hardware/NEMA 17 Stepper Motor.f3d
Hardware/Nut 8mm x 2mmPitch.f3d
Hardware/Nut 8mm x 2mmPitch.step
Hardware/Trapezoidal lead screw tr8x8-4.f3d
Printed Parts/Enclosure/3mm pin.f3d
Printed Parts/Enclosure/3mm pin.stl
Printed Parts/Enclosure/6mm pin.f3d
Printed Parts/Enclosure/6mm pin.stl
Printed Parts/Enclosure/Front Left Bottom Bracket.f3d
Printed Parts/Enclosure/Front Left Bottom Bracket.stl
Printed Parts/Enclosure/Front Left.f3d
Printed Parts/Enclosure/Front Left.stl
Printed Parts/Enclosure/Front Middle.f3d
Printed Parts/Enclosure/Front Middle.stl
Printed Parts/Enclosure/Front Right Bottom Bracket.f3d
Printed Parts/Enclosure/Front Right Bottom Bracket.stl
Printed Parts/Enclosure/Front Right.f3d
Printed Parts/Enclosure/Front Right.stl
Printed Parts/Enclosure/Front Stand 1.f3d
Printed Parts/Enclosure/Front Stand 1.stl
Printed Parts/Enclosure/Front Stand 2.f3d
Printed Parts/Enclosure/Front Stand 2.stl
Printed Parts/Enclosure/Front Stand Extension.f3d
Printed Parts/Enclosure/Front Stand Extension.stl
Printed Parts/Enclosure/Handle.f3d
Printed Parts/Enclosure/Handle.stl
Printed Parts/Enclosure/Hinge 1.f3d
Printed Parts/Enclosure/Hinge 1.stl
Printed Parts/Enclosure/Hinge 2.f3d
Printed Parts/Enclosure/Hinge 2.stl
Printed Parts/Enclosure/Latch.f3d
Printed Parts/Enclosure/Latch.stl
Printed Parts/Enclosure/Lock Pin.f3d
Printed Parts/Enclosure/Lock Pin.stl
Printed Parts/Enclosure/Sphere Left.f3d
Printed Parts/Enclosure/Sphere Left.stl
Printed Parts/Enclosure/Sphere Right.f3d
Printed Parts/Enclosure/Sphere Right.stl
Printed Parts/Enclosure/Top Left Bracket.f3d
Printed Parts/Enclosure/Top Left Bracket.stl
Printed Parts/Enclosure/Top Left Guide 1.f3d
Printed Parts/Enclosure/Top Left Guide 1.stl
Printed Parts/Enclosure/Top Left Guide 2.f3d
Printed Parts/Enclosure/Top Left Guide 2.stl
Printed Parts/Enclosure/Top Right Bracket.f3d
Printed Parts/Enclosure/Top Right Bracket.stl
Printed Parts/Enclosure/Top Right Guide 1.f3d
Printed Parts/Enclosure/Top Right Guide 1.stl
Printed Parts/Enclosure/Top Right Guide 2.f3d
Printed Parts/Enclosure/Top Right Guide 2.stl
Printed Parts/Filament Holder.f3d
Printed Parts/Fixing Block.f3d
Printed Parts/Fixing Block.stl
Printed Parts/Linear Bearing Block.f3d
Printed Parts/Linear Bearing Block.stl
Printed Parts/X Carriage.f3d
Printed Parts/X Carriage.stl
Printed Parts/X End Idler.f3d
Printed Parts/X End Idler.stl
Printed Parts/X End Motor.f3d
Printed Parts/X End Motor.stl
Printed Parts/X endstop.f3d
Printed Parts/X endstop.stl
Printed Parts/Y Bar Clamp.f3d
Printed Parts/Y Belt Holder.f3d
Printed Parts/Y Motor Bracket.f3d
Printed Parts/Z Bar Clamp.f3d
Printed Parts/Z Isolator.stl
Printed Parts/Z Stepper Bracket LHS.f3d
Printed Parts/Z Stepper Bracket LHS.stl
Printed Parts/Z Stepper Bracket RHS.f3d
Printed Parts/Z Stepper Bracket RHS.stl
Printed Parts/Z bar clamp.stl
Printed Parts/atx long.f3d
Printed Parts/atx long.stl
Printed Parts/atx short.f3d
Printed Parts/atx short.stl
Printed Parts/bed fan duct.f3d
Printed Parts/bed fan duct.stl
Printed Parts/fan guard.f3d
Printed Parts/fan guard.stl
Printed Parts/filament holder.stl
Printed Parts/spoolholder.f3d
Printed Parts/spoolholder.stl
Printed Parts/y bar clamp switch.f3d
Printed Parts/y bar clamp switch.stl
Printed Parts/y bar clamp.stl
Printed Parts/y belt holder.stl
Printed Parts/y idler bracket.f3d
Printed Parts/y idler bracket.stl
Printed Parts/y motor bracket.stl
Printed Parts/z isolator.f3d
Sheets/Base.dxf
Sheets/Base.f3d
Sheets/Enclosure/Back Window.dxf
Sheets/Enclosure/Back Window.f3d
Sheets/Enclosure/Door.dxf
Sheets/Enclosure/Door.f3d
Sheets/Enclosure/Rear 1.dxf
Sheets/Enclosure/Rear 1.f3d
Sheets/Enclosure/Rear 2.dxf
Sheets/Enclosure/Rear 2.f3d
Sheets/Enclosure/Side Window.dxf
Sheets/Enclosure/Side Window.f3d
Sheets/Gantry.dxf
Sheets/Gantry.f3d
Sheets/Left.dxf
Sheets/Left.f3d
Sheets/Right.dxf
Sheets/Right.f3d
Sheets/Y Carriage.dxf
Sheets/Y carriage.f3d
