cjsatuforc/Mendel-90/Build Manual (DRAFT - NOT COMPLETE OR VERIFIED)/Images/Enclosure/Enclosure both guides.png

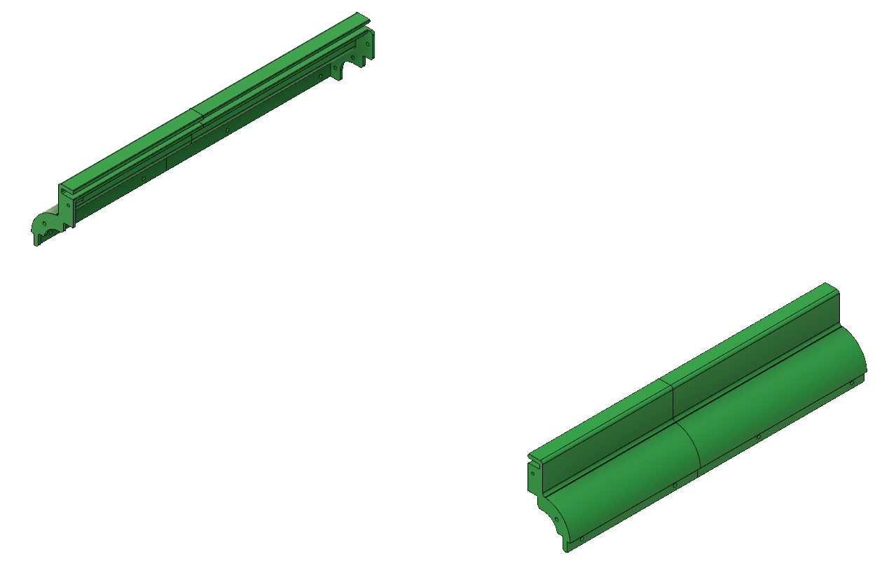
Build Manual (DRAFT - NOT COMPLETE OR VERIFIED)/Images/Enclosure/Enclosure both guides.png
