cjsatuforc/Mendel-90/Build Manual (DRAFT - NOT COMPLETE OR VERIFIED)/Images/Enclosure/Enclosure complete left guide.png

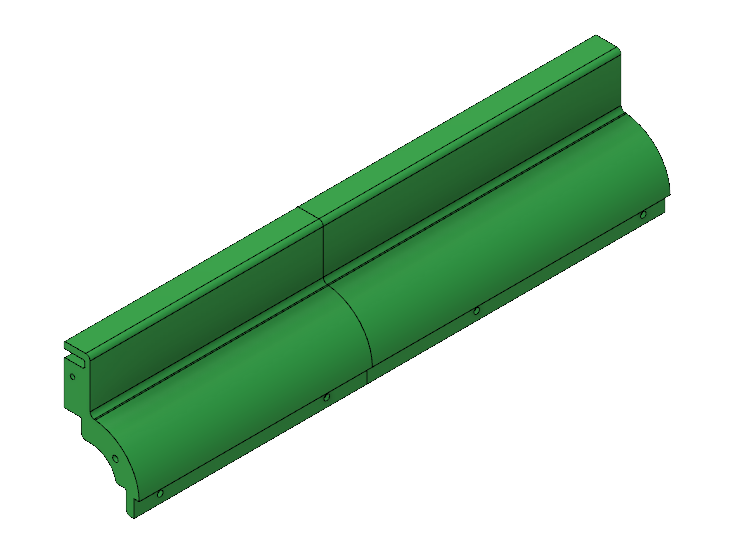
Build Manual (DRAFT - NOT COMPLETE OR VERIFIED)/Images/Enclosure/Enclosure complete left guide.png
