cjsatuforc/Mendel-90/Build Manual (DRAFT - NOT COMPLETE OR VERIFIED)/Images/Enclosure/Enclosure left guide with pin.png

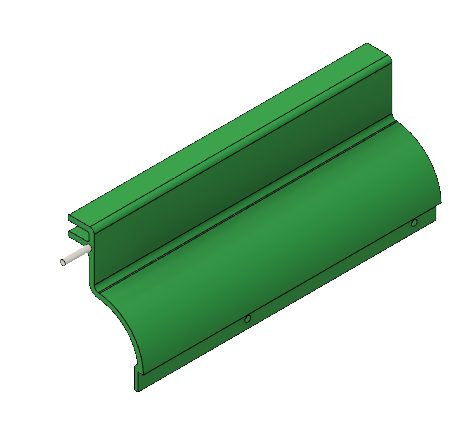
Build Manual (DRAFT - NOT COMPLETE OR VERIFIED)/Images/Enclosure/Enclosure left guide with pin.png
