cjsatuforc/Mendel-90/Build Manual (DRAFT - NOT COMPLETE OR VERIFIED)/Images/Enclosure/Fixing block assembly.png

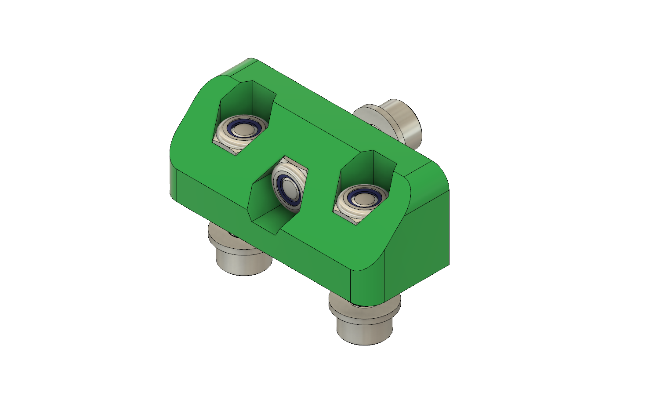
Build Manual (DRAFT - NOT COMPLETE OR VERIFIED)/Images/Enclosure/Fixing block assembly.png
