cjsatuforc/Mendel-90/Build Manual (DRAFT - NOT COMPLETE OR VERIFIED)/Chapter 0.odt

# Mendel90 Instructions

The build is broken down into sub assemblies that can be worked on sequentially by one person, or in parallel if there is more than one person building. For this reason each assembly begins on a new page so the instructions can be separated.

15-11-12 First release of this manual.

25-11-12 Made Z cable 100mm longer. Added advice about temperatures.

03-12-12 Fixed missing Z parts. Added Skienforge and bed sections.

30-11-12 Z bar clamps and Y bearing mounts no longer have separate switch versions.

21-12-12 T2.5 belt and pulleys, new extruder PCB and Jhead mount.

02-01-13 Minor corrections and suggestions from users.

03-03-13 Removed feed tube connector.

14-03-13 Updates from user feed back and latest part renders.

21-03-13 Added section on using other software.

20-05-13 Added warning about absolute extrusion.

12-09-13 New X ends, Z couplers and fan bracket.

18-09-13 New file locations, SF profile, etc.

01-10-13 Updated remaining assembly views for black screws and red silicone on hot end.

18-11-13 Added instruction to fit nut and grub screw to extruder gear.

12-01-14 Fixed erroneous reference to hex screws in X motor assembly.

17-01-14 Added requirement for Philips screwdriver for removing X and E motor screws.

Fixed erroneous z_min instead of z_max.

17-01-14 Clarified changing E_STEPS_PER_MM expression.

27-07-14 Small corrections and clarifications.

07-09-14 Fixed a few typos.

14-10-14 Fixed more typos.

12-03-15 Added bed cooling fan wiring details.

08-06-15 Changed belts and pulleys to GT2

02-08-16 Changed by tvrrug.co.uk to have all wires run on top of the base. This makes the wire runs as short as possible and makes the chances of wires getting caught less.

02-08-16 Changed by tvrrug.co.uk to use the Prusa I3 X carriage system but with the X motor still on the right.

02-08-16 Changed by tvrrug.co.uk to use the Mk42 Bed.

02-08-16 Changed by tvrrug.co.uk to not use cable clamps. They are replaced with silicone/rubber wires held in place with zipties at each end

Table of Contents

1.General Build Tips 6

Tools Required 8

Recommended 8

Consumables 8

2.Frame Assembly 9

Vitamins 9

Printed parts 9

Assembly 10

3.Bed Fan Assembly 13

Vitamins 13

Printed part 13

Assembly 13

4.X Idler Assembly 15

Vitamins 15

Printed 15

Assembly 16

5.X Motor Assembly 17

Vitamins 17

Printed parts 17

Assembly 18

6.Z Motor Assemblies 23

Vitamins 23

Printed parts 23

Assembly 24

7.Z Axis Assembly 26

Vitamins 26

Printed parts 26

Sub-assemblies 26

Assembly 27

8.Y idler assembly 29

Vitamins 29

Printed parts 29

Assembly 29

9.Y motor assembly 30

Vitamins 30

Printed parts 30

Assembly 31

10.Y Carriage Assembly 32

Vitamins 32

Printed parts 32

Assembly 33

11.Y Heatshield Assembly 34

Vitamins 34

Assembly 34

12.Print bed assembly 35

Vitamins 35

Sub-assemblies 35

Bed Wiring 36

Assembly 38

13.Y Axis Assembly 39

Vitamins 39

Printed parts 39

Sub-assemblies 39

Assembly 40

14.X Carriage Fan Assembly 42

Vitamins 42

Printed parts 42

Assembly 42

15.X Carriage Assembly 43

Vitamins 43

Printed parts 43

Assembly 44

16.Hot end assembly 45

Vitamins 45

Assembly 45

17.Extruder connection PCB assembly 47

Vitamins 47

Assembly 47

18.Extruder Motor Assembly 48

Vitamins 48

Printed parts 48

Sub-assemblies 48

Assembly 49

19.Extruder Assembly 51

Vitamins 51

Printed parts 51

Sub-assemblies 51

Assembly 52

20.X Axis Assembly 55

Vitamins 55

Sub-assemblies 55

Assembly 56

21.Spool holder assembly 58

Vitamins 58

Printed parts 58

Assembly 59

22.PSU assembly 60

Vitamins 60

Printed parts 60

Wiring 61

Summary 62

Assembly 63

23.Electronics Assembly 64

Vitamins 64

Printed Parts 64

Assembly 64

24.Software 68

Marlin Firmware 68

Arduino IDE 68

Pronterface 68

25.Testing 70

Jumpers 70

Power up 70

Limit switches 70

Motors 70

Heaters 71

Fan 71

26.Calibration 72

Bed Levelling 72

Extruder Calibration 73

Z Home Point 73

First Print 74

Slicing with Skeinforge 75

Extrusion Limits 76

27.Operating Instructions 77

Heated Bed 77

Changing filament 77

Removal 77

Insertion 78

Different types of filament 78

Cleaning the hobbed bolt 79

Using Other Software Tools 80
