cjsatuforc/Mendel-90/Build Manual (DRAFT - NOT COMPLETE OR VERIFIED)/Chapter 1.odt

## 1. General Build Tips

- X is left / right. Y is backwards / forwards. Z is up / down.
- De-grease the rods. Acetone or methylated spirit works. Dont worry they will be oiled later.
- All screws have a plain washer where they meet the plastic/sheets, to spread the load and prevent the plastic being chewed up by the rotation of the screw head. Most fixings have a captive Nyloc nut to prevent them vibrating loose. It is very important that the nut is fully seated in the nut trap while the screw is inserted. They are quite a tight fit, so sometimes it is necessary to pull or push them in with a long screw.
- The X and Y bar clamps should not be over tightened, i.e. do not close the gap fully or the parts will break. The Y and Z bars only need a light clamping force because the only force trying to slide them is the bearing friction.
- Washers tend to have a smooth side and a side with a burr from being stamped out. Make sure the smooth side faces bearings and belts.

NOTE: During this manual 3mm fiberboard was used. It’s cheaper for prototyping.

NOTE: It’s optional, but might be a good idea to drill all holes to their spec’ed size. If a 4mm screw is used in the hole drill it to 4mm. Endstop switches normally 2.5 holes but you can drill them to 3mm if you talke care. This is the method used in this manual.

### Tools Required

- Allen keys: 1.5 & 2.5mm & 3mm
- Needle nose pliers.
- 8mm sharp drill bit
- 3mm
- 4mm
- 2mm
- Drill with variable speed
- Small hammer
- Marker or pen
- M3 tap
- Wire cutters.
- Wire strippers.
- Crimp tool for dupont connectors – You can solder but its not nearly as good as crimping

#### Recommended

- Multi-meter
- Digital callipers.
- Dial gauge and/or Set of feeler blades(to level the bed more - precise than paper method)
- Heat gun for heat shrink tubing… far better than lighter or soldering iron
- Ruler and square. Even thou it should be 90 degrees, it does not hurt to check.

#### Consumables

- oil, white lithium grease, alcohol (for cleaning bed), lint free wipes.
