cjsatuforc/Mendel-90/Build Manual (DRAFT - NOT COMPLETE OR VERIFIED)/Chapter 10.odt

## 10. Y Carriage Assembly

### Vitamins

14 M3 cap screw x 16mm 1 Dibond sheet 216mm x 216mm x 3mm 3 LM8UU bearings | 14 Nyloc nut M3 14 Washer M3 x 7mm x 0.5mm 3 Zip-tie 100mm min length

### Printed parts

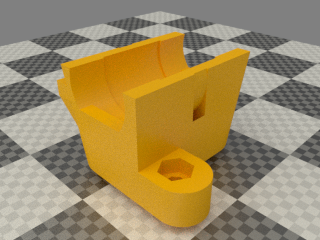
[picture p62: figure]

| | 3 y_bearing_mount.stl

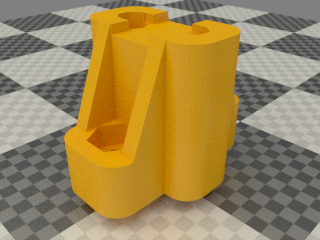
[picture p63: figure]
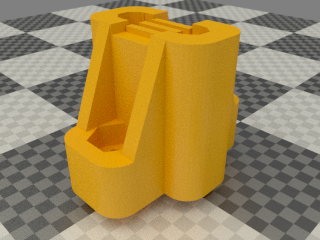
[picture p64: figure]

1 y_belt_anchor.stl | 1 y_belt_anchor_toothed.stl

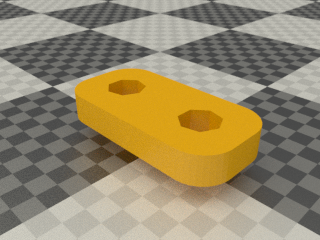
[picture p65: figure]
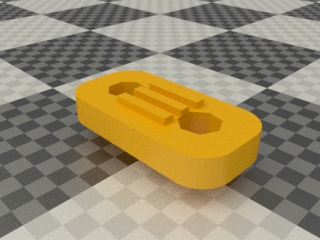
[picture p66: figure]

1 y_belt_clip.stl | 1 y_belt_clip_toothed.stl

### Assembly

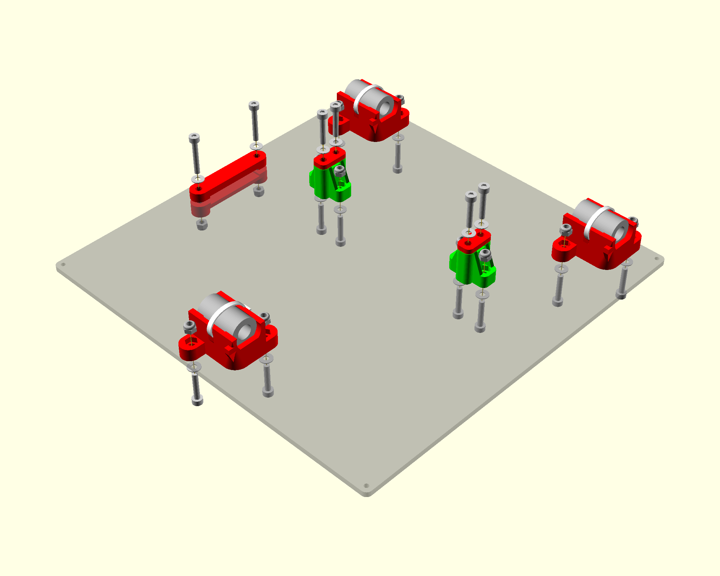
[picture p67: figure]

This view is from the bottom of the bed which is the matt side of the Dibond. The nuts go on the bottom and the screw heads and washers on top.

1. Insert M3 nyloc nuts into all of the nut traps, including those that go all the way up to the top of the belt anchors. A long M3 screw can be used to pull them up to the top.
2. Tie the bushingss into the holders with the zip ties, and screw the holders to the carriage using M3 x 16mm screws and washers. Note that one side of the bearing holders has a tab to trigger the limit switch and that must face forwards (that is, away from the ribbon clamp).
  TIP: use the square to help make the rod and holders parallel to the edge
3. Align the two bearings on the left (right on the picture) by inserting a rod and lining up the tabs with the edge of the board before tightening the screws. Leave the third bearing loose.
4. Fit the belt clamps loosely to retain the nuts using M3 x 16mm screws and washers, then fit the anchors to the carriage using M3 x 16mm screw and washers. Note that the anchor with the teeth goes at the back (nearest to the ribbon clamp) and the belt clamp with the teeth at the front.
