cjsatuforc/Mendel-90/Build Manual (DRAFT - NOT COMPLETE OR VERIFIED)/Chapter 11.odt

## Y Heatshield Assembly

The heatshield insulates the bottom surface of the heated bed to allow it to get hot enough for ABS. It isn't needed for printing PLA . If you want to print ABS it can be added later as it just slides under the bed. It is simply made from enough layers of corrugated cardboard to fill the air gap. The bottom layer has holes cut in it to clear the screws heads on the y-carriage and a slot to clear the ribbon cable. The higher layers just need the slot. The top layer will need an additional slot to clear the thermistor.

### Vitamins

1 Corrugated cardboard 192mm x 216mm x 5mm.

### Assembly

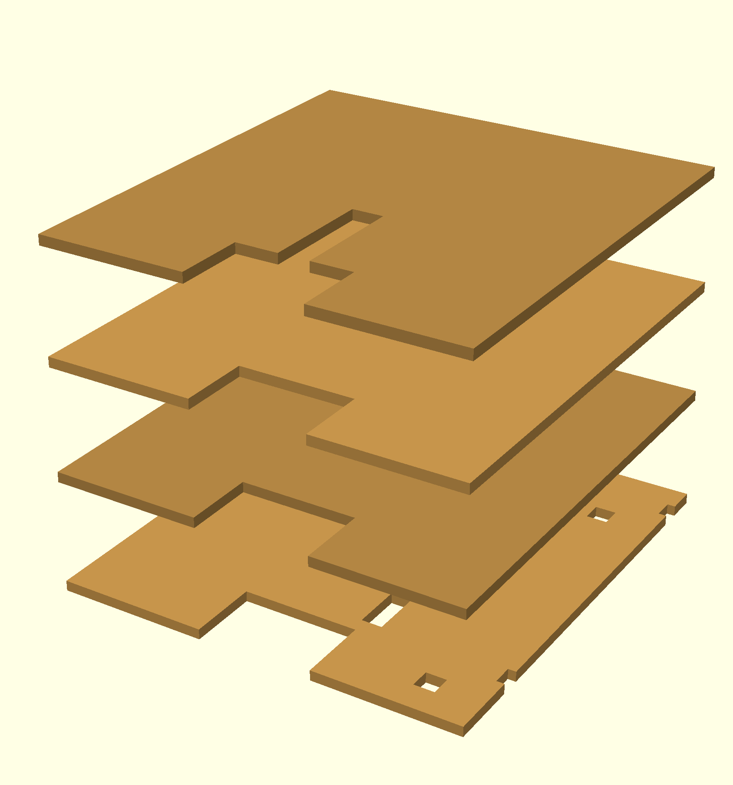
[picture p68: figure]

(http://reprap.org/wiki/File:Mendel90-Heatshield.png)
