cjsatuforc/Mendel-90/Build Manual (DRAFT - NOT COMPLETE OR VERIFIED)/Chapter 2.odt

## 2. Frame Assembly

### Vitamins.

48 M4 cap screw x 16mm 2 Dibond sheet ?mm x ?mm x 3mm 1 Dibond sheet ?mm x ?mm x 3mm 1 Dibond sheet ?mm x ?mm x 3mm | 48 Nyloc nut M4 48 Washer M4 x 9mm x 0.8mm 29 Zip-tie 100mm min length

### Printed parts

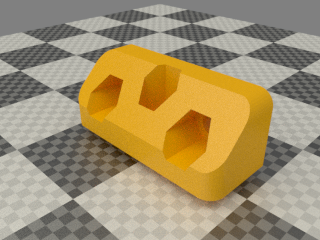
[picture p76: figure]

16 fixing_block.stl

### Assembly

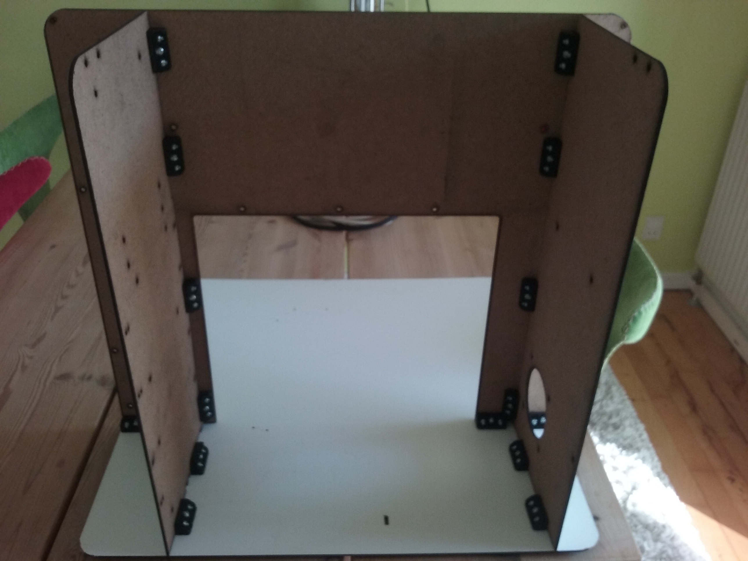
[picture p77: figure]

Note that this view is from the back of the machine.

1. Remove the protective film from the Dibond panels. They all have a matt side and a shiny side. The shiny side is up on the base, forward on the gantry and outside on the stays.
2. Insert M4 nyloc nuts into each of the three nut traps in the fixing blocks (a small pair of snipe nose pliers is useful for pressing them home).

TIP: You can also use the nose pliers to hold the nyloc while tighten the screws. Once they starts to seat in the fixing block you should be able to put down the pliers,

3. Loosely attach twelve fixing blocks to the left and right stays with two M4 x 16mm screws and washers each, noting that they go on the matt side that faces inwards.
4. Stand each sheet on its edges on a flat surface and slide the block down to be flush with the edge before tightening the screws. Tighten just enough to nip the sheets together but don't over-tighten.
5. Fit the remaining four fixing blocks along the bottom of the back of the gantry (large n shaped sheet) in the same way.
6. Fix the stays to the back of the gantry using one screw in each fixing block. Note the shiny sides face outwards and the one with the fan hole is on the left hand side looking from the front. Tighten the screws.
7. Loosely screw the gantry to the base using M4 x 16mm screws and washers from below into the nut traps in the fixing blocks.
8. Loosely insert ties into the pairs of small holes in the right stay and base. The joins should be under the base and on the right stay towards the left stay.
9. Use a square to check that all sheets stand on a 90 angle to each other. It can take some fiddle work to get them at right angles but the better the frame is the better and more easy the rest of the build will be.

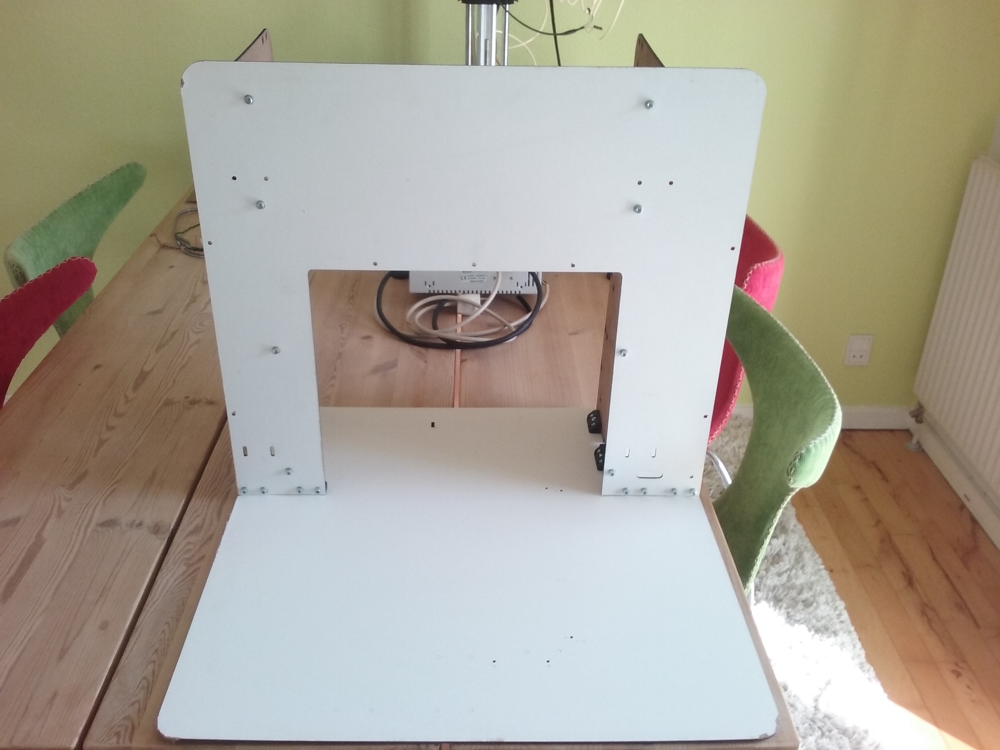
[picture p78: figure]
