cjsatuforc/Mendel-90/Build Manual (DRAFT - NOT COMPLETE OR VERIFIED)/Images/Enclosure/Enclosure1.png

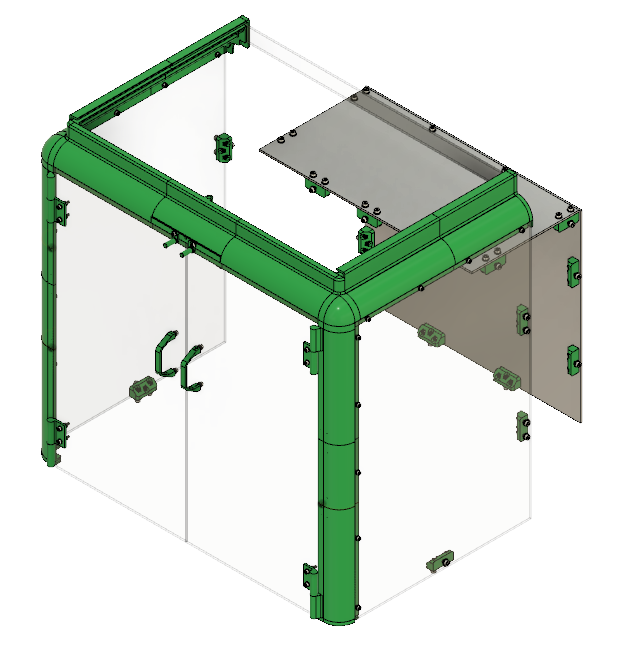
Build Manual (DRAFT - NOT COMPLETE OR VERIFIED)/Images/Enclosure/Enclosure1.png
