cjsatuforc/Mendel-90/(commit log)

2018-03-31 initial upload
    Most hardware parts and sub assemblies
    [80mm fan.f3d, ATX Assembly.step, Ball Bearing 624.f3d, Bed bearing assembly.step, Bed fan assembly.step, Fixing Block.f3d, Fixing block assembly.step, Flexible Coupling.f3d]
2018-04-03 more parts and assemblies
    [5015 Fan.f3d, 8mm Smooth Rod 336mm Long.f3d, 8mm Smooth Rod 445 mm Long.f3d, 8mm Smooth Rod 481mm Long.f3d, Bed Fan Guard.f3d, E3D V6 1.75mm.f3d, Front Left Bottom Bracket Assembly.step, Front Left Bottom Bracket.f3d]
2018-04-10 another set of files
    [40mm Fan.f3d, ATX PSU.f3d, Ball Bearing 608.f3d, Drag Chain.f3d, E3D V6 Bowden Assembly.step, E3d V6 Heatsink And Part Cooling Duct 40mm Fans.f3d, Filament Holder Assembly.step, Filament Holder.f3d]
